dariusz-majchrzak/Meritum-2/Meritum2_KLT/img/Meritum2_KLT_BOT.png

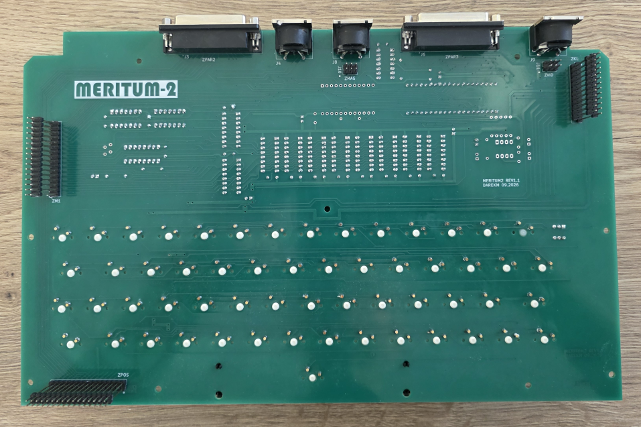
Meritum2_KLT/img/Meritum2_KLT_BOT.png
