dariusz-majchrzak/Meritum-2/Meritum2_KLT/img/Meritum2_KLT_PCB_TOP.png

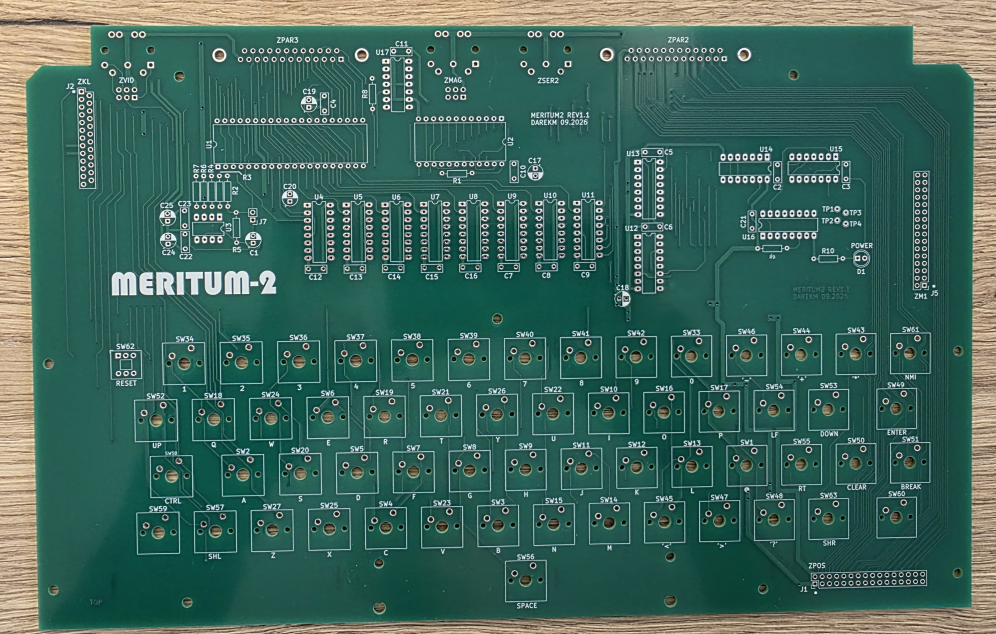
Meritum2_KLT/img/Meritum2_KLT_PCB_TOP.png
