dariusz-majchrzak/Meritum-2/Meritum2_KLT/img/Meritum2_KLT_TOP.png

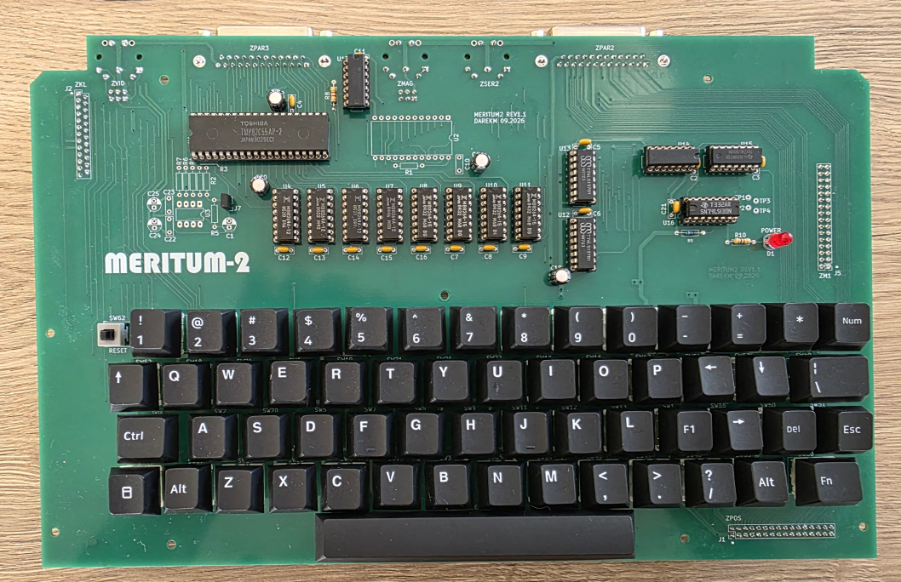
Meritum2_KLT/img/Meritum2_KLT_TOP.png
