dariusz-majchrzak/Meritum-2/Meritum2_PGW/img/Meritum2_PCBs_stack1.png

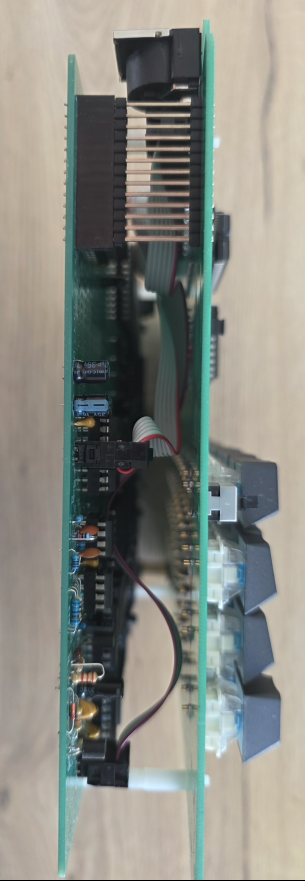
Meritum2_PGW/img/Meritum2_PCBs_stack1.png
