dariusz-majchrzak/Meritum-2/Meritum2_PGW/img/Meritum2_PGW_PCB_BOT.png

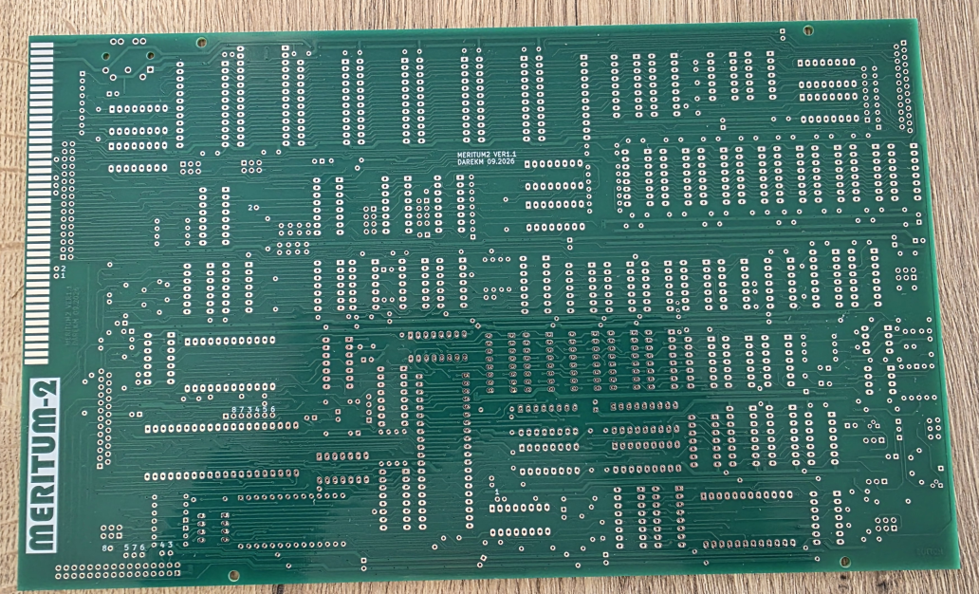
Meritum2_PGW/img/Meritum2_PGW_PCB_BOT.png
