dariusz-majchrzak/Meritum-2/Meritum2_KLT/schematic/Meritum2_KLT.pdf

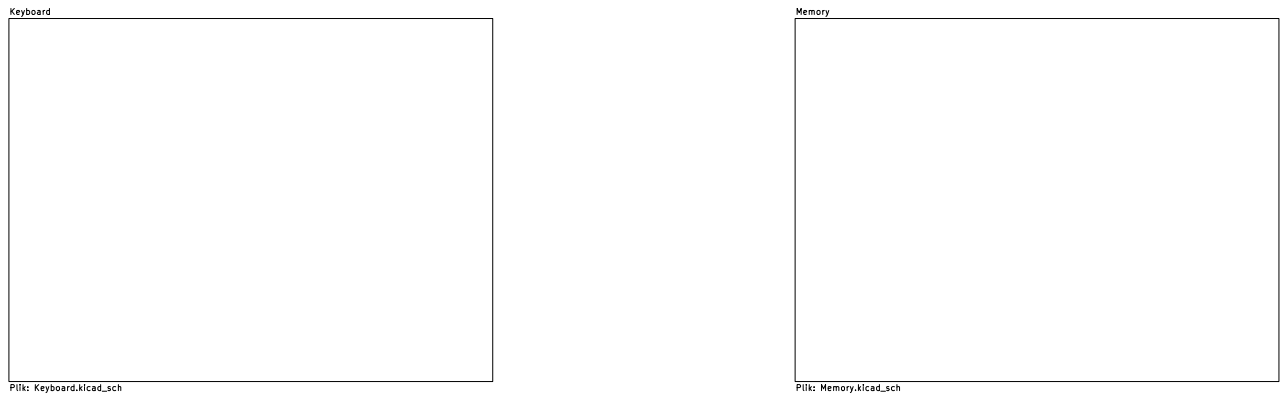
[picture p18: page 1]

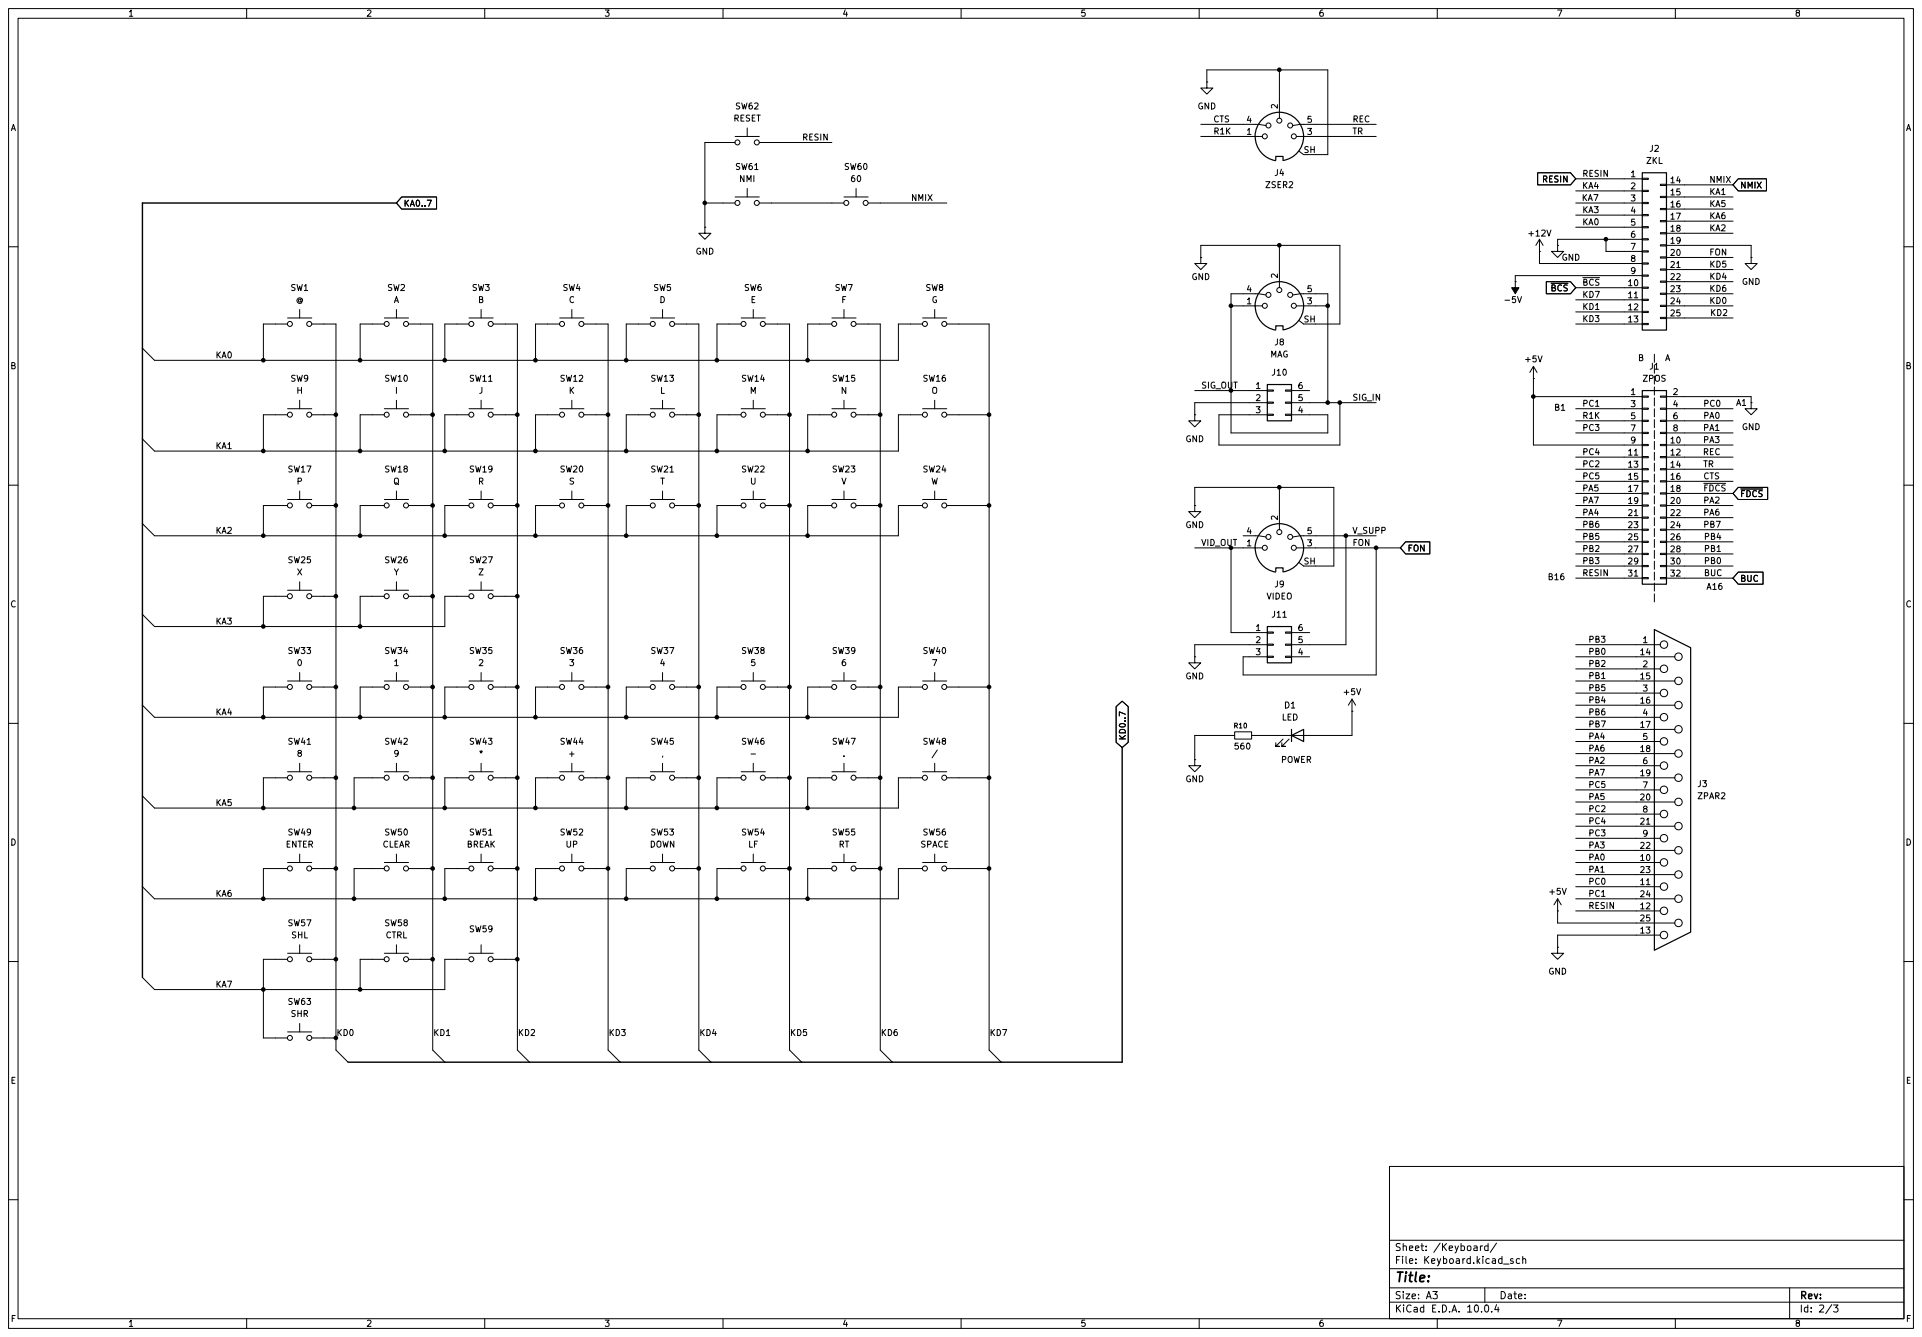
[picture p19: page 2]

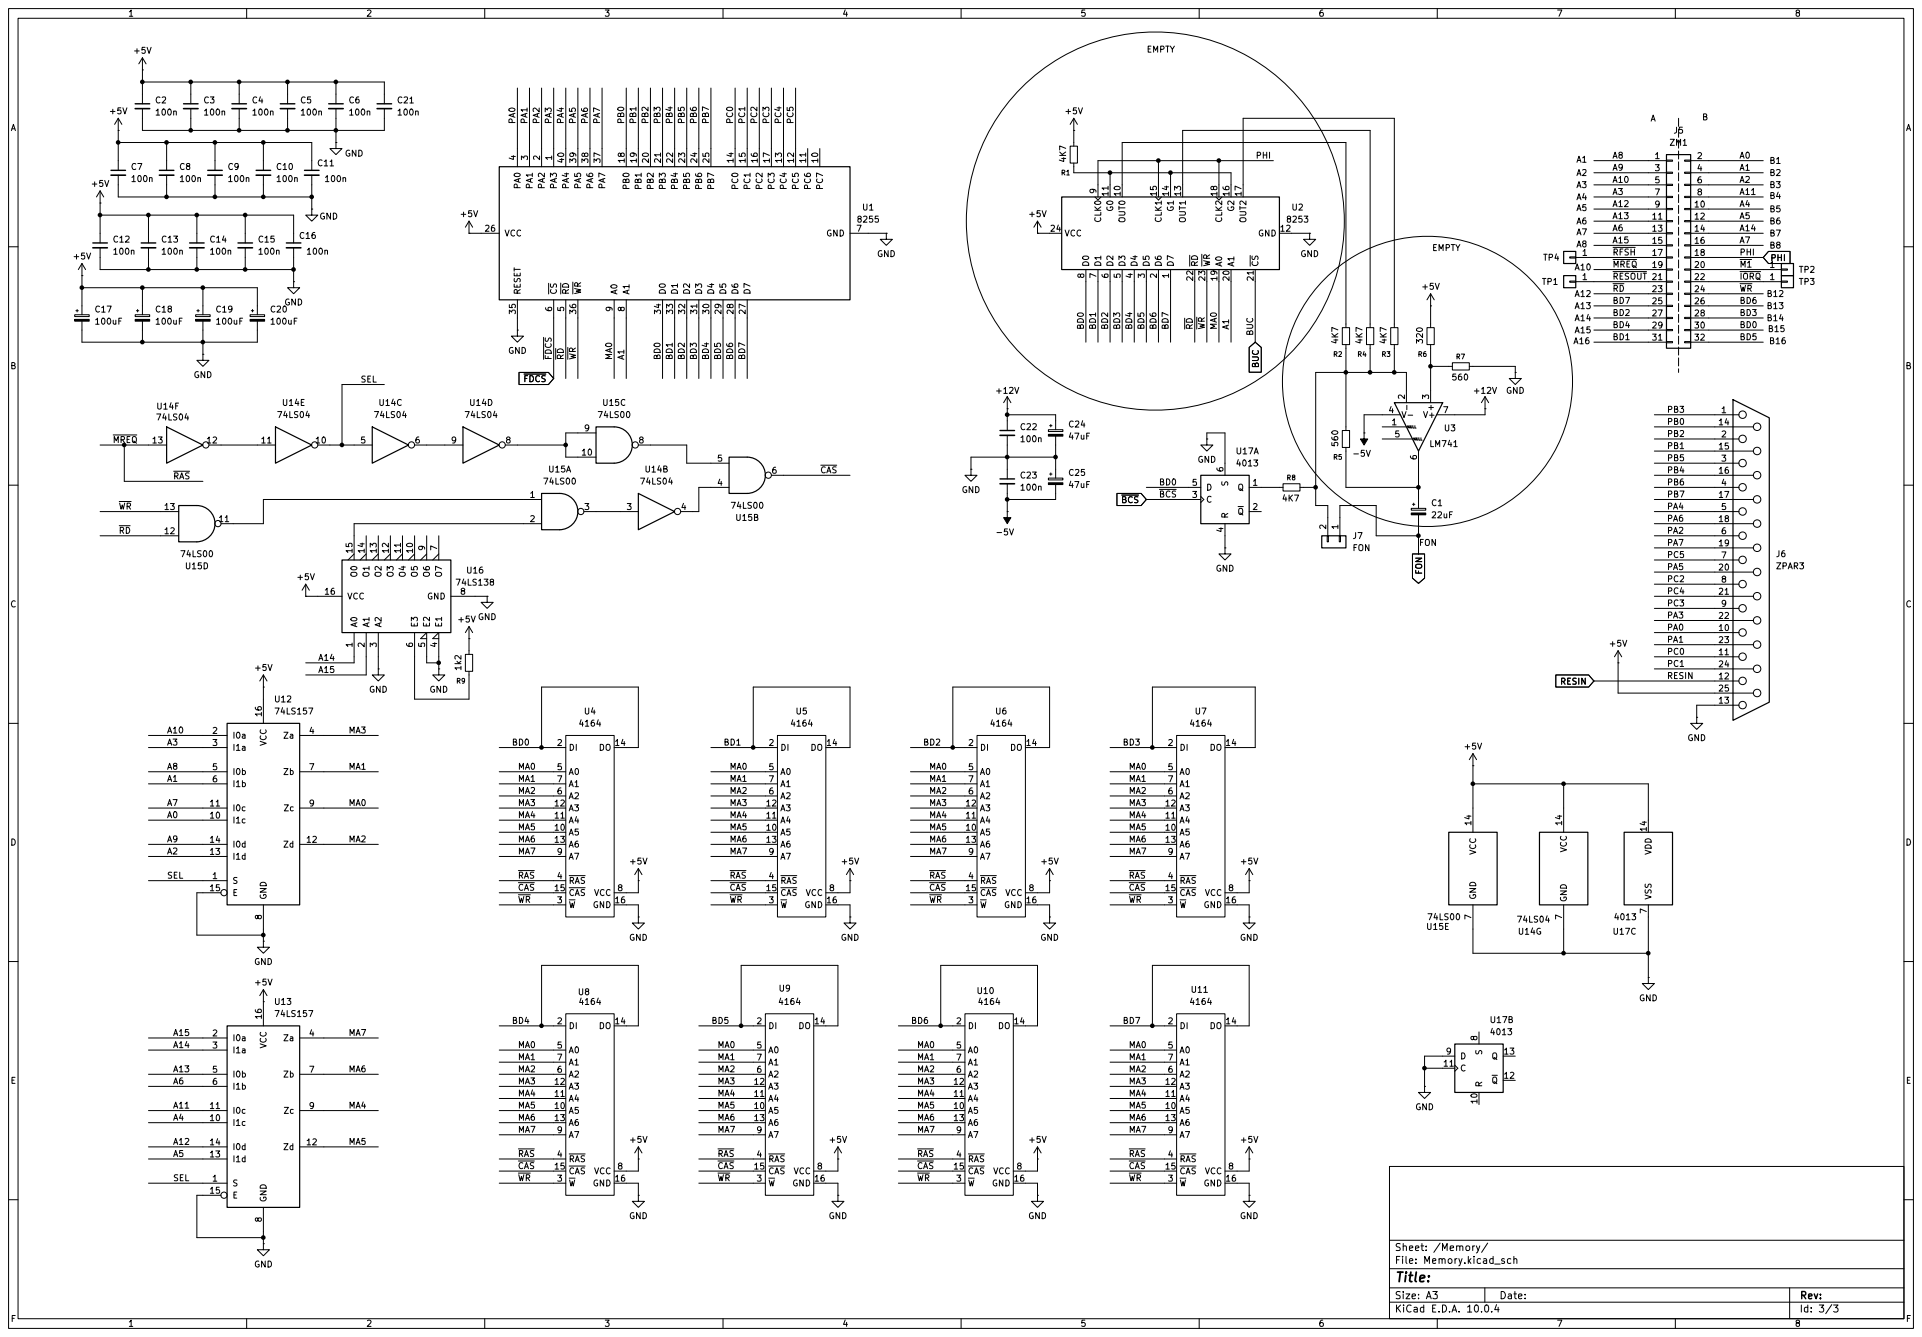
[picture p20: page 3]
