dariusz-majchrzak/Meritum-2/Meritum2_KLT/kicad/Meritum_KLT.kicad_pcb

## KiCad design Meritum2_KLT/kicad/Meritum_KLT.kicad_pcb (2026-11-09)

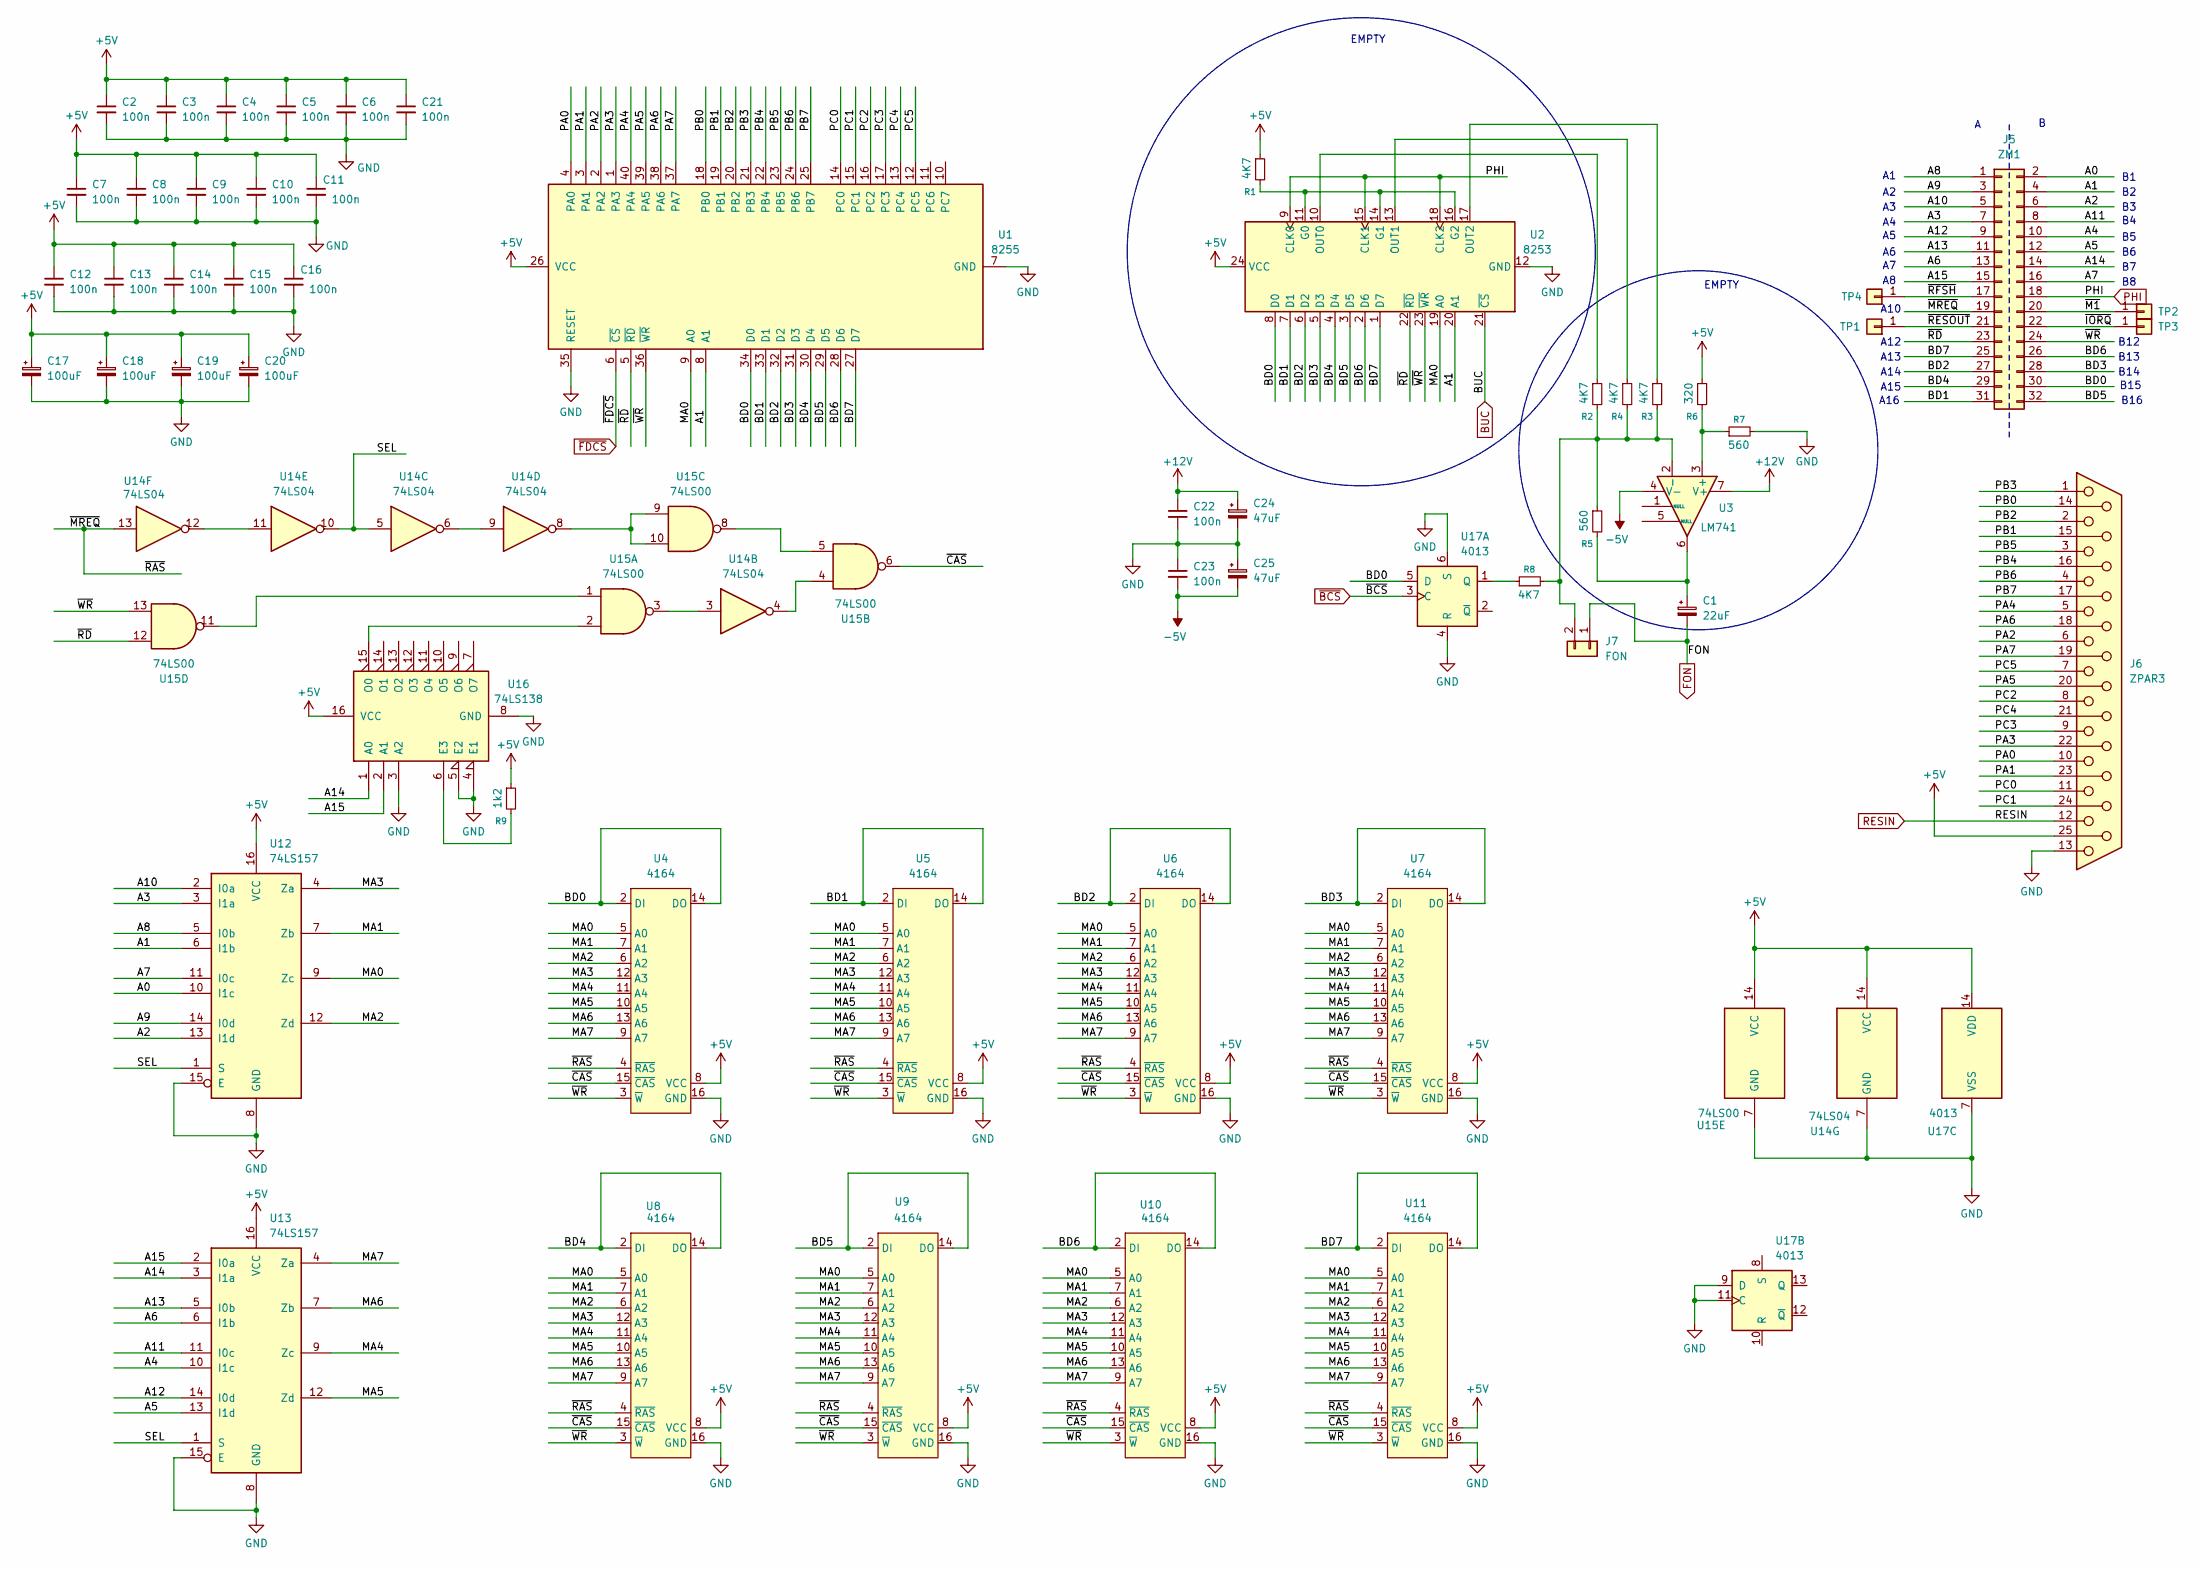
[picture p21: schematic Memory.kicad_sch]

Parts:
C1: 22uF; CP_Radial_D5.0mm_P2.50mm
C2, C3, C4, C5, C6, C7, C8, C9, C10, C11, C12, C13, C14, C15, C16, C21, C22, C23: 100n; C_Rect_L7.0mm_W2.5mm_P5.00mm
C17, C18, C19, C20: 100uF; CP_Radial_D5.0mm_P2.50mm
C24, C25: 47uF; CP_Radial_D5.0mm_P2.50mm
J5: ZM1; PinHeader_2x16_P2.54mm_Vertical
J6: ZPAR3; DSUB-25_Socket_Horizontal_P2.77x2.84mm_EdgePinOffset7.70mm_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
J7: FON; PinHeader_1x02_P2.54mm_Vertical
R1, R2, R3, R4, R8: 4K7; r_400
R5, R7: 560; r_400
R6: 320; r_400
R9: 1k2; r_400
TP1, TP2, TP3, TP4: TP; pin
U1: 8255; DIP-40_W15.24mm
U2: 8253; DIP-24_W15.24mm
U3: LM741; DIP-8_W7.62mm_LongPads
U4, U5, U6, U7, U8, U9, U10, U11: 4164; DIP-16_W7.62mm_LongPads
U12, U13: 74LS157; DIP-16_W7.62mm_LongPads
U14: 74LS04; DIP-14_W7.62mm_LongPads
U15: 74LS00; DIP-14_W7.62mm_LongPads
U16: 74LS138; DIP-16_W7.62mm_LongPads
U17: 4013; DIP-14_W7.62mm_LongPads

Connections:
+5V: C2.1, C3.1, C4.1, C5.1, C6.1, C7.1, C8.1, C9.1, C10.1, C11.1, C12.1, C13.1, C14.1, C15.1, C16.1, C17.1, C18.1, C19.1, C20.1, C21.1, J6.25, R1.1, R6.1, R9.1, U1.26 (VCC), U2.24 (VCC), U4.8 (VCC), U5.8 (VCC), U6.8 (VCC), U7.8 (VCC), U8.8 (VCC), U9.8 (VCC), U10.8 (VCC), U11.8 (VCC), U12.16 (VCC), U13.16 (VCC), U14.14 (VCC), U15.14 (VCC), U16.16 (VCC), U17.14 (VDD); also elsewhere on the board
+12V: C22.1, C24.1, U3.7 (V+); also elsewhere on the board
-5V: C23.2, C25.2, U3.4 (V-); also elsewhere on the board
/Memory/A0: J5.2, U12.10 (I1c)
/Memory/A1: J5.4, U1.8 (A1), U2.20 (A1), U12.6 (I1b)
/Memory/A2: J5.6, U12.13 (I1d)
/Memory/A3: J5.7, U12.3 (I1a)
/Memory/A4: J5.10, U13.10 (I1c)
/Memory/A5: J5.12, U13.13 (I1d)
/Memory/A6: J5.13, U13.6 (I1b)
/Memory/A7: J5.16, U12.11 (I0c)
/Memory/A8: J5.1, U12.5 (I0b)
/Memory/A9: J5.3, U12.14 (I0d)
/Memory/A10: J5.5, U12.2 (I0a)
/Memory/A11: J5.8, U13.11 (I0c)
/Memory/A12: J5.9, U13.14 (I0d)
/Memory/A13: J5.11, U13.5 (I0b)
/Memory/A14: J5.14, U13.3 (I1a), U16.1 (A0)
/Memory/A15: J5.15, U13.2 (I0a), U16.2 (A1)
/Memory/BD0: J5.30, U1.34 (D0), U2.8 (D0), U4.2 (DI), U4.14 (DO), U17.5 (D)
/Memory/BD1: J5.31, U1.33 (D1), U2.7 (D1), U5.2 (DI), U5.14 (DO)
/Memory/BD2: J5.27, U1.32 (D2), U2.6 (D2), U6.2 (DI), U6.14 (DO)
/Memory/BD3: J5.28, U1.31 (D3), U2.5 (D3), U7.2 (DI), U7.14 (DO)
/Memory/BD4: J5.29, U1.30 (D4), U2.4 (D4), U8.2 (DI), U8.14 (DO)
/Memory/BD5: J5.32, U1.29 (D5), U2.3 (D5), U9.2 (DI), U9.14 (DO)
/Memory/BD6: J5.26, U1.28 (D6), U2.2 (D6), U10.2 (DI), U10.14 (DO)
/Memory/BD7: J5.25, U1.27 (D7), U2.1 (D7), U11.2 (DI), U11.14 (DO)
/Memory/MA0: U1.9 (A0), U2.19 (A0), U4.5 (A0), U5.5 (A0), U6.5 (A0), U7.5 (A0), U8.5 (A0), U9.5 (A0), U10.5 (A0), U11.5 (A0), U12.9 (Zc)
/Memory/MA1: U4.7 (A1), U5.7 (A1), U6.7 (A1), U7.7 (A1), U8.7 (A1), U9.7 (A1), U10.7 (A1), U11.7 (A1), U12.7 (Zb)
/Memory/MA2: U4.6 (A2), U5.6 (A2), U6.6 (A2), U7.6 (A2), U8.6 (A2), U9.6 (A2), U10.6 (A2), U11.6 (A2), U12.12 (Zd)
/Memory/MA3: U4.12 (A3), U5.12 (A3), U6.12 (A3), U7.12 (A3), U8.12 (A3), U9.12 (A3), U10.12 (A3), U11.12 (A3), U12.4 (Za)
/Memory/MA4: U4.11 (A4), U5.11 (A4), U6.11 (A4), U7.11 (A4), U8.11 (A4), U9.11 (A4), U10.11 (A4), U11.11 (A4), U13.9 (Zc)
/Memory/MA5: U4.10 (A5), U5.10 (A5), U6.10 (A5), U7.10 (A5), U8.10 (A5), U9.10 (A5), U10.10 (A5), U11.10 (A5), U13.12 (Zd)
/Memory/MA6: U4.13 (A6), U5.13 (A6), U6.13 (A6), U7.13 (A6), U8.13 (A6), U9.13 (A6), U10.13 (A6), U11.13 (A6), U13.7 (Zb)
/Memory/MA7: U4.9 (A7), U5.9 (A7), U6.9 (A7), U7.9 (A7), U8.9 (A7), U9.9 (A7), U10.9 (A7), U11.9 (A7), U13.4 (Za)
/Memory/PA0: J6.10, U1.4 (PA0)
/Memory/PA1: J6.23, U1.3 (PA1)
/Memory/PA2: J6.6, U1.2 (PA2)
/Memory/PA3: J6.22, U1.1 (PA3)
/Memory/PA4: J6.5, U1.40 (PA4)
/Memory/PA5: J6.20, U1.39 (PA5)
/Memory/PA6: J6.18, U1.38 (PA6)
/Memory/PA7: J6.19, U1.37 (PA7)
/Memory/PB0: J6.14, U1.18 (PB0)
/Memory/PB1: J6.15, U1.19 (PB1)
/Memory/PB2: J6.2, U1.20 (PB2)
/Memory/PB3: J6.1, U1.21 (PB3)
/Memory/PB4: J6.16, U1.22 (PB4)
/Memory/PB5: J6.3, U1.23 (PB5)
/Memory/PB6: J6.4, U1.24 (PB6)
/Memory/PB7: J6.17, U1.25 (PB7)
/Memory/PC0: J6.11, U1.14 (PC0)
/Memory/PC1: J6.24, U1.15 (PC1)
/Memory/PC2: J6.8, U1.16 (PC2)
/Memory/PC3: J6.9, U1.17 (PC3)
/Memory/PC4: J6.21, U1.13 (PC4)
/Memory/PC5: J6.7, U1.12 (PC5)
/Memory/SEL: U12.1 (S), U13.1 (S), U14.5, U14.10
/Memory/~CAS: U4.15 (~CAS), U5.15 (~CAS), U6.15 (~CAS), U7.15 (~CAS), U8.15 (~CAS), U9.15 (~CAS), U10.15 (~CAS), U11.15 (~CAS), U15.6
/Memory/~IORQ: J5.22, TP3.1 (Pin_1_1)
/Memory/~M1: J5.20, TP2.1 (Pin_1_1)
/Memory/~MREQ: J5.19, U4.4 (~RAS), U5.4 (~RAS), U6.4 (~RAS), U7.4 (~RAS), U8.4 (~RAS), U9.4 (~RAS), U10.4 (~RAS), U11.4 (~RAS), U14.13
/Memory/~RD: J5.23, U1.5 (~RD), U2.22 (~RD), U15.12
/Memory/~RESOUT: J5.21, TP1.1 (Pin_1_1)
/Memory/~RFSH: J5.17, TP4.1 (Pin_1_1)
/Memory/~WR: J5.24, U1.36 (~WR), U2.23 (~WR), U4.3 (~W), U5.3 (~W), U6.3 (~W), U7.3 (~W), U8.3 (~W), U9.3 (~W), U10.3 (~W), U11.3 (~W), U15.13
BUC: U2.21 (~CS); also elsewhere on the board
FON: C1.2, J7.1; also elsewhere on the board
GND: C2.2, C3.2, C4.2, C5.2, C6.2, C7.2, C8.2, C9.2, C10.2, C11.2, C12.2, C13.2, C14.2, C15.2, C16.2, C17.2, C18.2, C19.2, C20.2, C21.2, C22.2, C23.1, C24.2, C25.1, J6.13, R7.2, U1.7 (GND), U1.35 (RESET), U2.12 (GND), U4.16 (GND), U5.16 (GND), U6.16 (GND), U7.16 (GND), U8.16 (GND), U9.16 (GND), U10.16 (GND), U11.16 (GND), U12.8 (GND), U12.15 (E), U13.8 (GND), U13.15 (E), U14.7 (GND), U15.7 (GND), U16.3 (A2), U16.4 (E1), U16.5 (E2), U16.8 (GND), U17.4 (R), U17.6 (S), U17.7 (VSS), U17.9 (D), U17.11 (C); also elsewhere on the board
unnamed: C1.1, R5.2, U3.6
unnamed: J7.2, R2.2, R3.2, R4.2, R5.1, R8.2, U3.2 (-)
unnamed: R1.2, U2.11 (G0), U2.14 (G1), U2.16 (G2)
unnamed: R2.1, U2.10 (OUT0)
unnamed: R4.1, U2.13 (OUT1)
unnamed: R3.1, U2.17 (OUT2)
unnamed: R6.2, R7.1, U3.3 (+)
unnamed: U14.3, U15.3
unnamed: U14.4, U15.4
unnamed: U14.6, U14.9
unnamed: U14.8, U15.9, U15.10
unnamed: U14.11, U14.12
unnamed: U15.1, U15.11
unnamed: U15.5, U15.8
unnamed: R9.2, U16.6 (E3)
unnamed: U15.2, U16.15 (O0)
unnamed: R8.1, U17.1 (Q)
PHI: J5.18, U2.9 (CLK0), U2.15 (CLK1), U2.18 (CLK2)
RESIN: J6.12; also elsewhere on the board
~BCS: U17.3 (C); also elsewhere on the board
~FDCS: U1.6 (~CS); also elsewhere on the board

Notes on the sheet:
B13
B12
EMPTY
A16
B15
A15
B16
A14
A13
A10
A12
B14

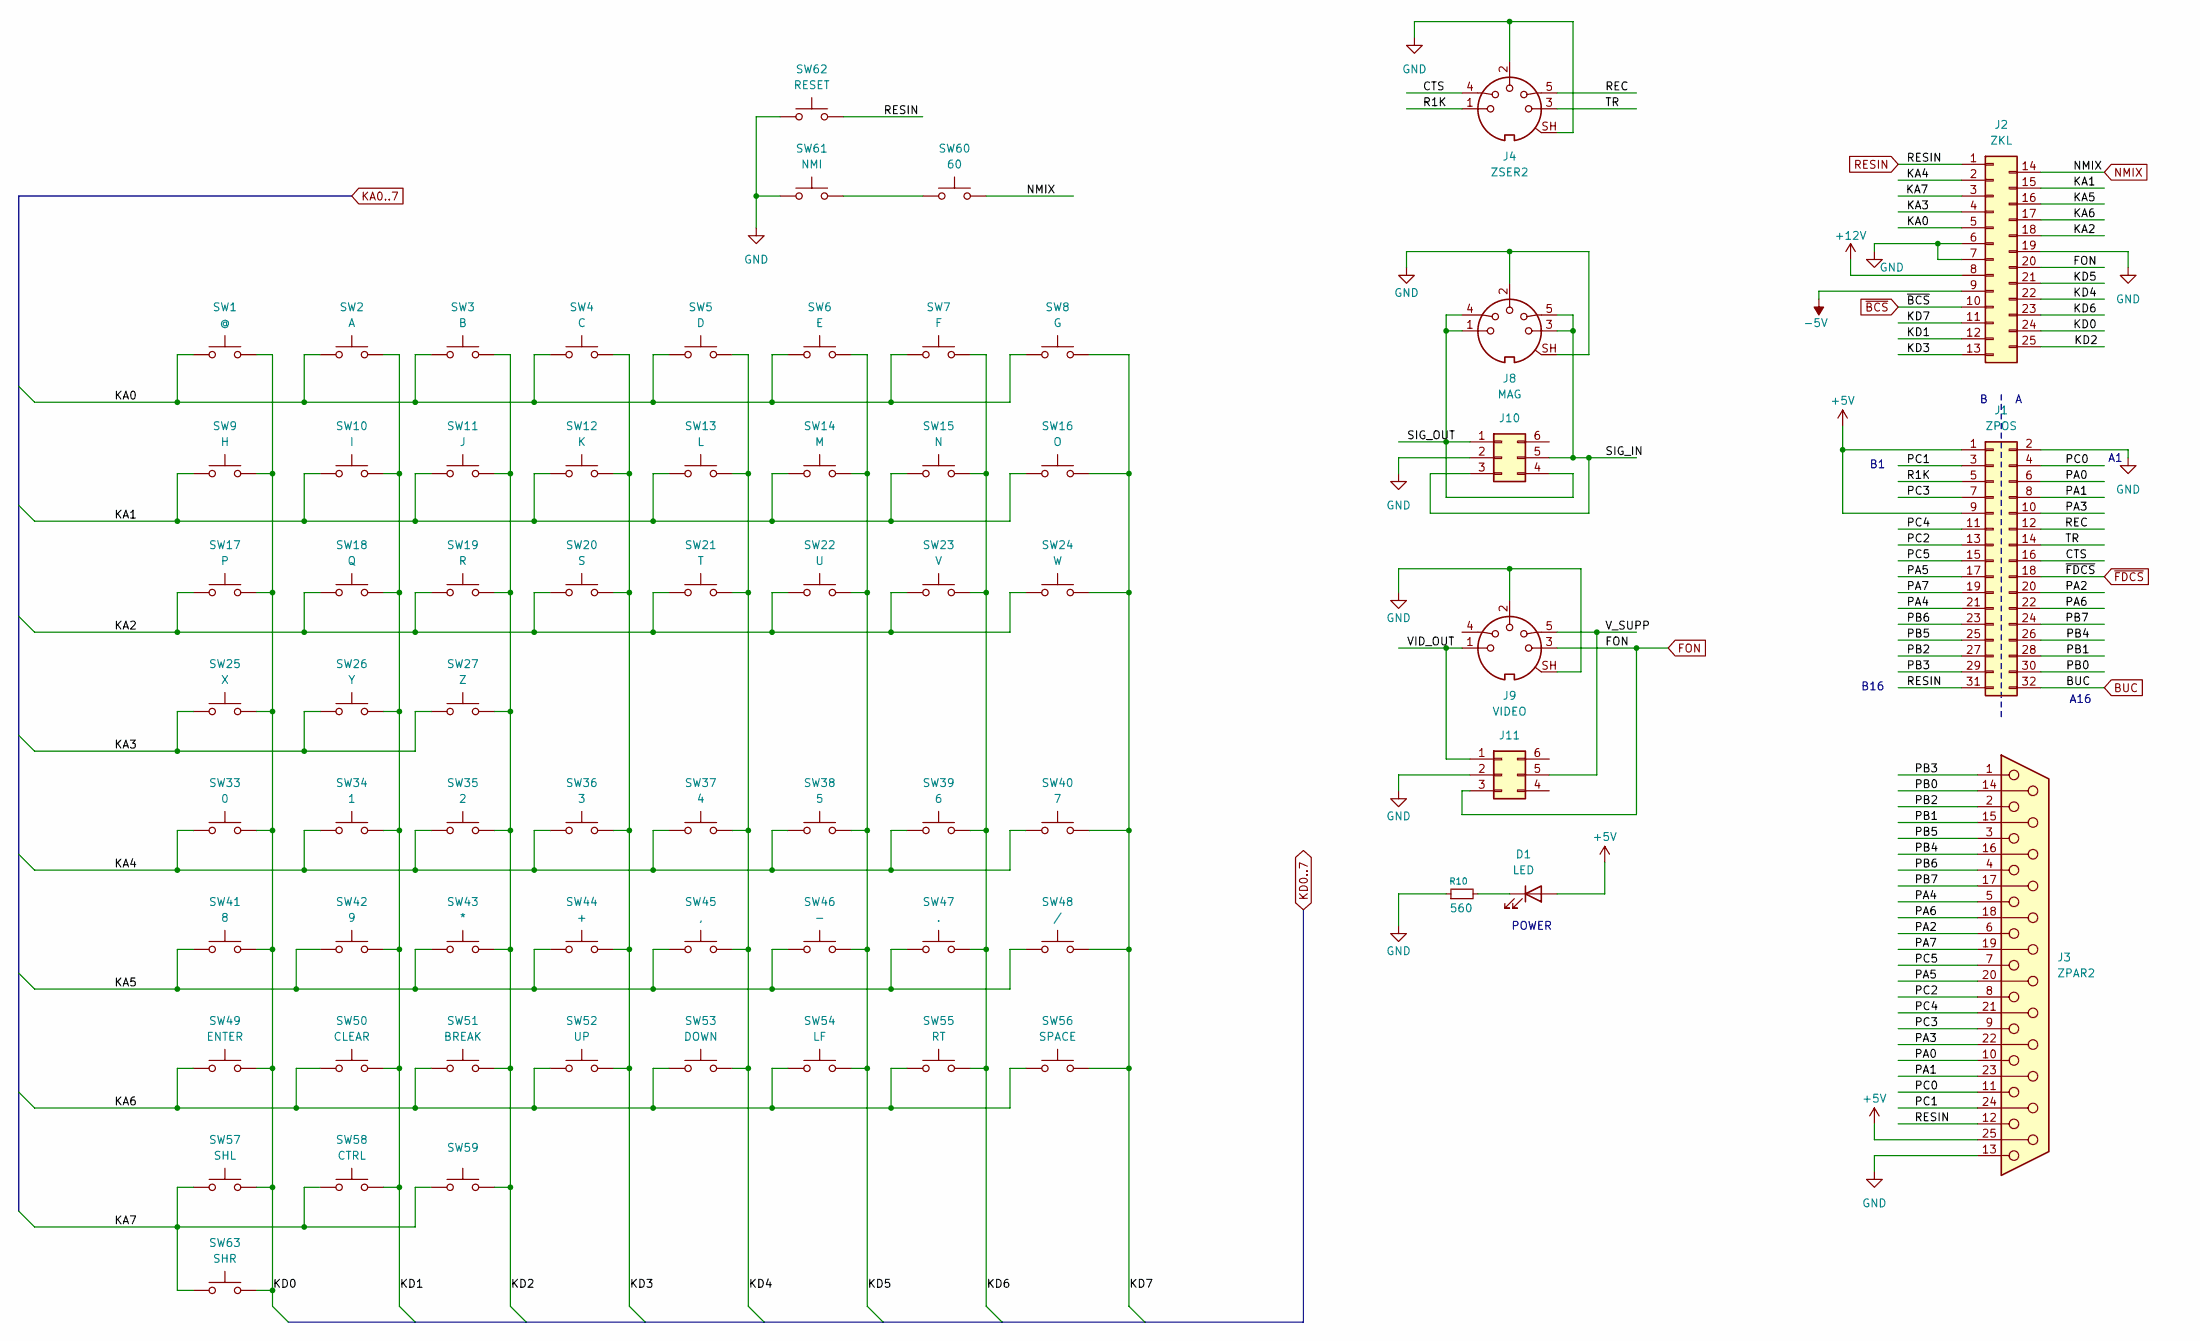
[picture p22: schematic Keyboard.kicad_sch]

Parts:
D1: LED; LED_D5.0mm
J1: ZPOS; PinHeader_2x16_P2.54mm_Vertical
J2: ZKL; PinSocket_25_P2.54mm_Vertical
J3: ZPAR2; DSUB-25_Socket_Horizontal_P2.77x2.84mm_EdgePinOffset7.70mm_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
J4: ZSER2; CUI_SDS-50J
J8: MAG; CUI_SDS-50J
J9: VIDEO; CUI_SDS-50J
J10, J11: Conn_02x03_Counter_Clockwise; PinHeader_2x03_P2.54mm_Vertical
R10: 560; r_400
SW1: @; SW_Cherry_MX_1.00u_PCB
SW2: A; SW_Cherry_MX_1.00u_PCB
SW3: B; SW_Cherry_MX_1.00u_PCB
SW4: C; SW_Cherry_MX_1.00u_PCB
SW5: D; SW_Cherry_MX_1.00u_PCB
SW6: E; SW_Cherry_MX_1.00u_PCB
SW7: F; SW_Cherry_MX_1.00u_PCB
SW8: G; SW_Cherry_MX_1.00u_PCB
SW9: H; SW_Cherry_MX_1.00u_PCB
SW10: I; SW_Cherry_MX_1.00u_PCB
SW11: J; SW_Cherry_MX_1.00u_PCB
SW12: K; SW_Cherry_MX_1.00u_PCB
SW13: L; SW_Cherry_MX_1.00u_PCB
SW14: M; SW_Cherry_MX_1.00u_PCB
SW15: N; SW_Cherry_MX_1.00u_PCB
SW16: O; SW_Cherry_MX_1.00u_PCB
SW17: P; SW_Cherry_MX_1.00u_PCB
SW18: Q; SW_Cherry_MX_1.00u_PCB
SW19: R; SW_Cherry_MX_1.00u_PCB
SW20: S; SW_Cherry_MX_1.00u_PCB
SW21: T; SW_Cherry_MX_1.00u_PCB
SW22: U; SW_Cherry_MX_1.00u_PCB
SW23: V; SW_Cherry_MX_1.00u_PCB
SW24: W; SW_Cherry_MX_1.00u_PCB
SW25: X; SW_Cherry_MX_1.00u_PCB
SW26: Y; SW_Cherry_MX_1.00u_PCB
SW27: Z; SW_Cherry_MX_1.00u_PCB
SW33: 0; SW_Cherry_MX_1.00u_PCB
SW34: 1; SW_Cherry_MX_1.00u_PCB
SW35: 2; SW_Cherry_MX_1.00u_PCB
SW36: 3; SW_Cherry_MX_1.00u_PCB
SW37: 4; SW_Cherry_MX_1.00u_PCB
SW38: 5; SW_Cherry_MX_1.00u_PCB
SW39: 6; SW_Cherry_MX_1.00u_PCB
SW40: 7; SW_Cherry_MX_1.00u_PCB
SW41: 8; SW_Cherry_MX_1.00u_PCB
SW42: 9; SW_Cherry_MX_1.00u_PCB
SW43: *; SW_Cherry_MX_1.00u_PCB
SW44: +; SW_Cherry_MX_1.00u_PCB
SW45: ,; SW_Cherry_MX_1.00u_PCB
SW46: -; SW_Cherry_MX_1.00u_PCB
SW47: .; SW_Cherry_MX_1.00u_PCB
SW48: /; SW_Cherry_MX_1.00u_PCB
SW49: ENTER; SW_Cherry_MX_1.50u_PCB
SW50: CLEAR; SW_Cherry_MX_1.00u_PCB
SW51: BREAK; SW_Cherry_MX_1.00u_PCB
SW52: UP; SW_Cherry_MX_1.00u_PCB
SW53: DOWN; SW_Cherry_MX_1.00u_PCB
SW54: LF; SW_Cherry_MX_1.00u_PCB
SW55: RT; SW_Cherry_MX_1.00u_PCB
SW56: SPACE; SW_Cherry_MX_6.25u_PCB
SW57: SHL; SW_Cherry_MX_1.00u_PCB
SW58: CTRL; SW_Cherry_MX_1.50u_PCB
SW59: SW_Cherry_MX_1.00u_PCB
SW60: 60; SW_Cherry_MX_1.50u_PCB
SW61: NMI; SW_Cherry_MX_1.00u_PCB
SW62: RESET; SW_Push_2P2T_Toggle_CK_PVA2OAH5xxxxxxV2
SW63: SHR; SW_Cherry_MX_1.00u_PCB

Connections:
+5V: D1.2 (A), J1.1, J1.9, J3.25; also elsewhere on the board
+12V: J2.8; also elsewhere on the board
-5V: J2.9; also elsewhere on the board
/Keyboard/CTS: J1.16, J4.4
/Keyboard/KA0: J2.5, SW1.1, SW2.1, SW3.1, SW4.1, SW5.1, SW6.1, SW7.1, SW8.1
/Keyboard/KA1: J2.15, SW9.1, SW10.1, SW11.1, SW12.1, SW13.1, SW14.1, SW15.1, SW16.1
/Keyboard/KA2: J2.18, SW17.1, SW18.1, SW19.1, SW20.1, SW21.1, SW22.1, SW23.1, SW24.1
/Keyboard/KA3: J2.4, SW25.1, SW26.1, SW27.1
/Keyboard/KA4: J2.2, SW33.1, SW34.1, SW35.1, SW36.1, SW37.1, SW38.1, SW39.1, SW40.1
/Keyboard/KA5: J2.16, SW41.1, SW42.1, SW43.1, SW44.1, SW45.1, SW46.1, SW47.1, SW48.1
/Keyboard/KA6: J2.17, SW49.1, SW50.1, SW51.1, SW52.1, SW53.1, SW54.1, SW55.1, SW56.1
/Keyboard/KA7: J2.3, SW57.1, SW58.1, SW59.1, SW63.1
/Keyboard/KD0: J2.24, SW1.2, SW9.2, SW17.2, SW25.2, SW33.2, SW41.2, SW49.2, SW57.2, SW63.2
/Keyboard/KD1: J2.12, SW2.2, SW10.2, SW18.2, SW26.2, SW34.2, SW42.2, SW50.2, SW58.2
/Keyboard/KD2: J2.25, SW3.2, SW11.2, SW19.2, SW27.2, SW35.2, SW43.2, SW51.2, SW59.2
/Keyboard/KD3: J2.13, SW4.2, SW12.2, SW20.2, SW36.2, SW44.2, SW52.2
/Keyboard/KD4: J2.22, SW5.2, SW13.2, SW21.2, SW37.2, SW45.2, SW53.2
/Keyboard/KD5: J2.21, SW6.2, SW14.2, SW22.2, SW38.2, SW46.2, SW54.2
/Keyboard/KD6: J2.23, SW7.2, SW15.2, SW23.2, SW39.2, SW47.2, SW55.2
/Keyboard/KD7: J2.11, SW8.2, SW16.2, SW24.2, SW40.2, SW48.2, SW56.2
/Keyboard/PA0: J1.6, J3.10
/Keyboard/PA1: J1.8, J3.23
/Keyboard/PA2: J1.20, J3.6
/Keyboard/PA3: J1.10, J3.22
/Keyboard/PA4: J1.21, J3.5
/Keyboard/PA5: J1.17, J3.20
/Keyboard/PA6: J1.22, J3.18
/Keyboard/PA7: J1.19, J3.19
/Keyboard/PB0: J1.30, J3.14
/Keyboard/PB1: J1.28, J3.15
/Keyboard/PB2: J1.27, J3.2
/Keyboard/PB3: J1.29, J3.1
/Keyboard/PB4: J1.26, J3.16
/Keyboard/PB5: J1.25, J3.3
/Keyboard/PB6: J1.23, J3.4
/Keyboard/PB7: J1.24, J3.17
/Keyboard/PC0: J1.4, J3.11
/Keyboard/PC1: J1.3, J3.24
/Keyboard/PC2: J1.13, J3.8
/Keyboard/PC3: J1.7, J3.9
/Keyboard/PC4: J1.11, J3.21
/Keyboard/PC5: J1.15, J3.7
/Keyboard/R1K: J1.5, J4.1
/Keyboard/REC: J1.12, J4.5
/Keyboard/SIG_IN: J8.3, J8.5, J10.3, J10.5
/Keyboard/SIG_OUT: J8.1, J8.4, J10.1, J10.4
/Keyboard/TR: J1.14, J4.3
/Keyboard/VID_OUT: J9.1, J11.1
/Keyboard/V_SUPP: J9.5, J11.5
BUC: J1.32; also elsewhere on the board
FON: J2.20, J9.3, J11.3; also elsewhere on the board
GND: J1.2, J2.6, J2.7, J2.19, J3.13, J4.2, J4.SH, J8.2, J8.SH, J9.2, J9.SH, J10.2, J11.2, R10.1, SW61.1, SW62.1; also elsewhere on the board
NMIX: J2.14, SW60.2
unnamed: D1.1 (K), R10.2
unnamed: SW60.1, SW61.2
RESIN: J1.31, J2.1, J3.12, SW62.2; also elsewhere on the board
~BCS: J2.10; also elsewhere on the board
~FDCS: J1.18; also elsewhere on the board

Notes on the sheet:
POWER
B16
A16

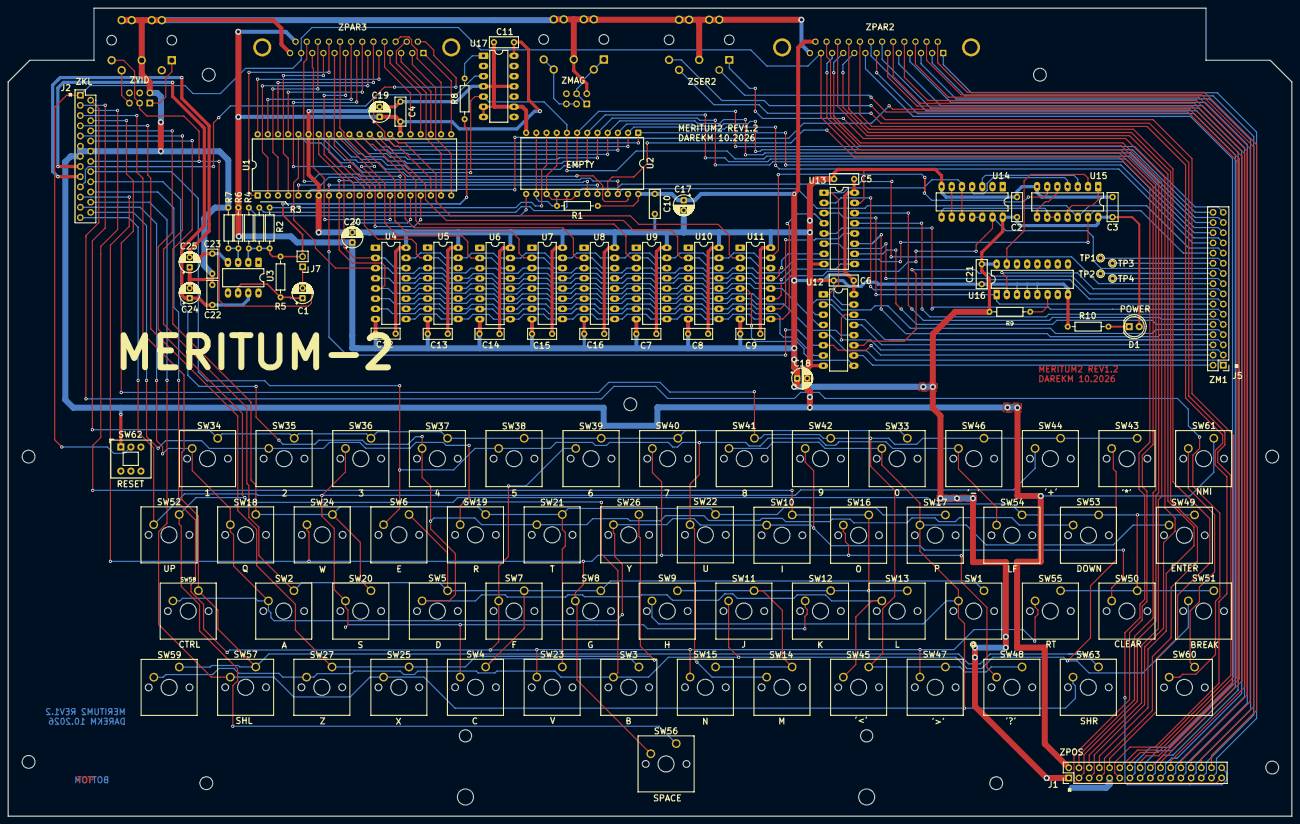
[picture p23: board Meritum_KLT.kicad_pcb from above]

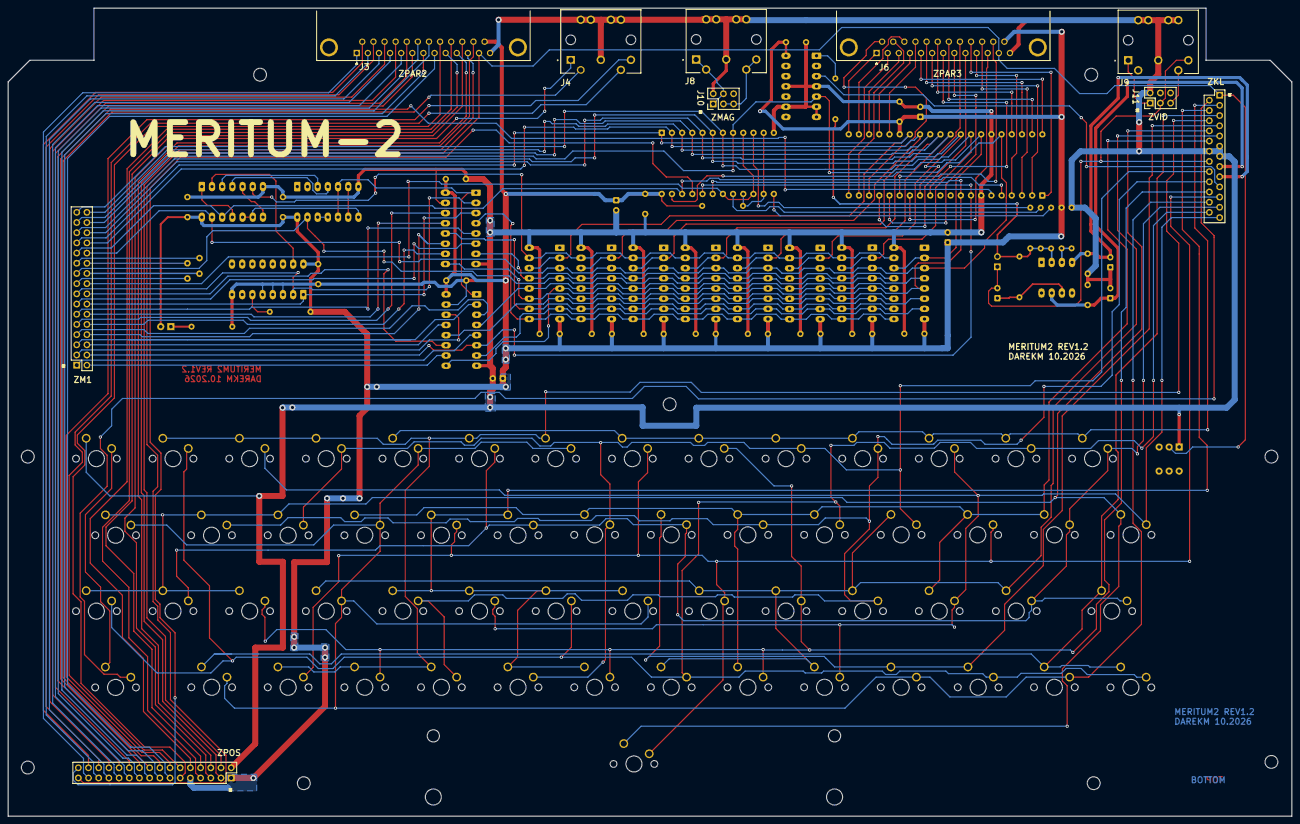
[picture p24: board Meritum_KLT.kicad_pcb from below]

Board: 2 copper layers, 320.0 x 201.4 mm, 126 parts (7 on the bottom side), 139 nets.
