dariusz-majchrzak/Meritum-2/Meritum2_PGW/kicad/Meritum_PGW.kicad_pcb

## KiCad design Meritum2_PGW/kicad/Meritum_PGW.kicad_pcb (2026-11-09)

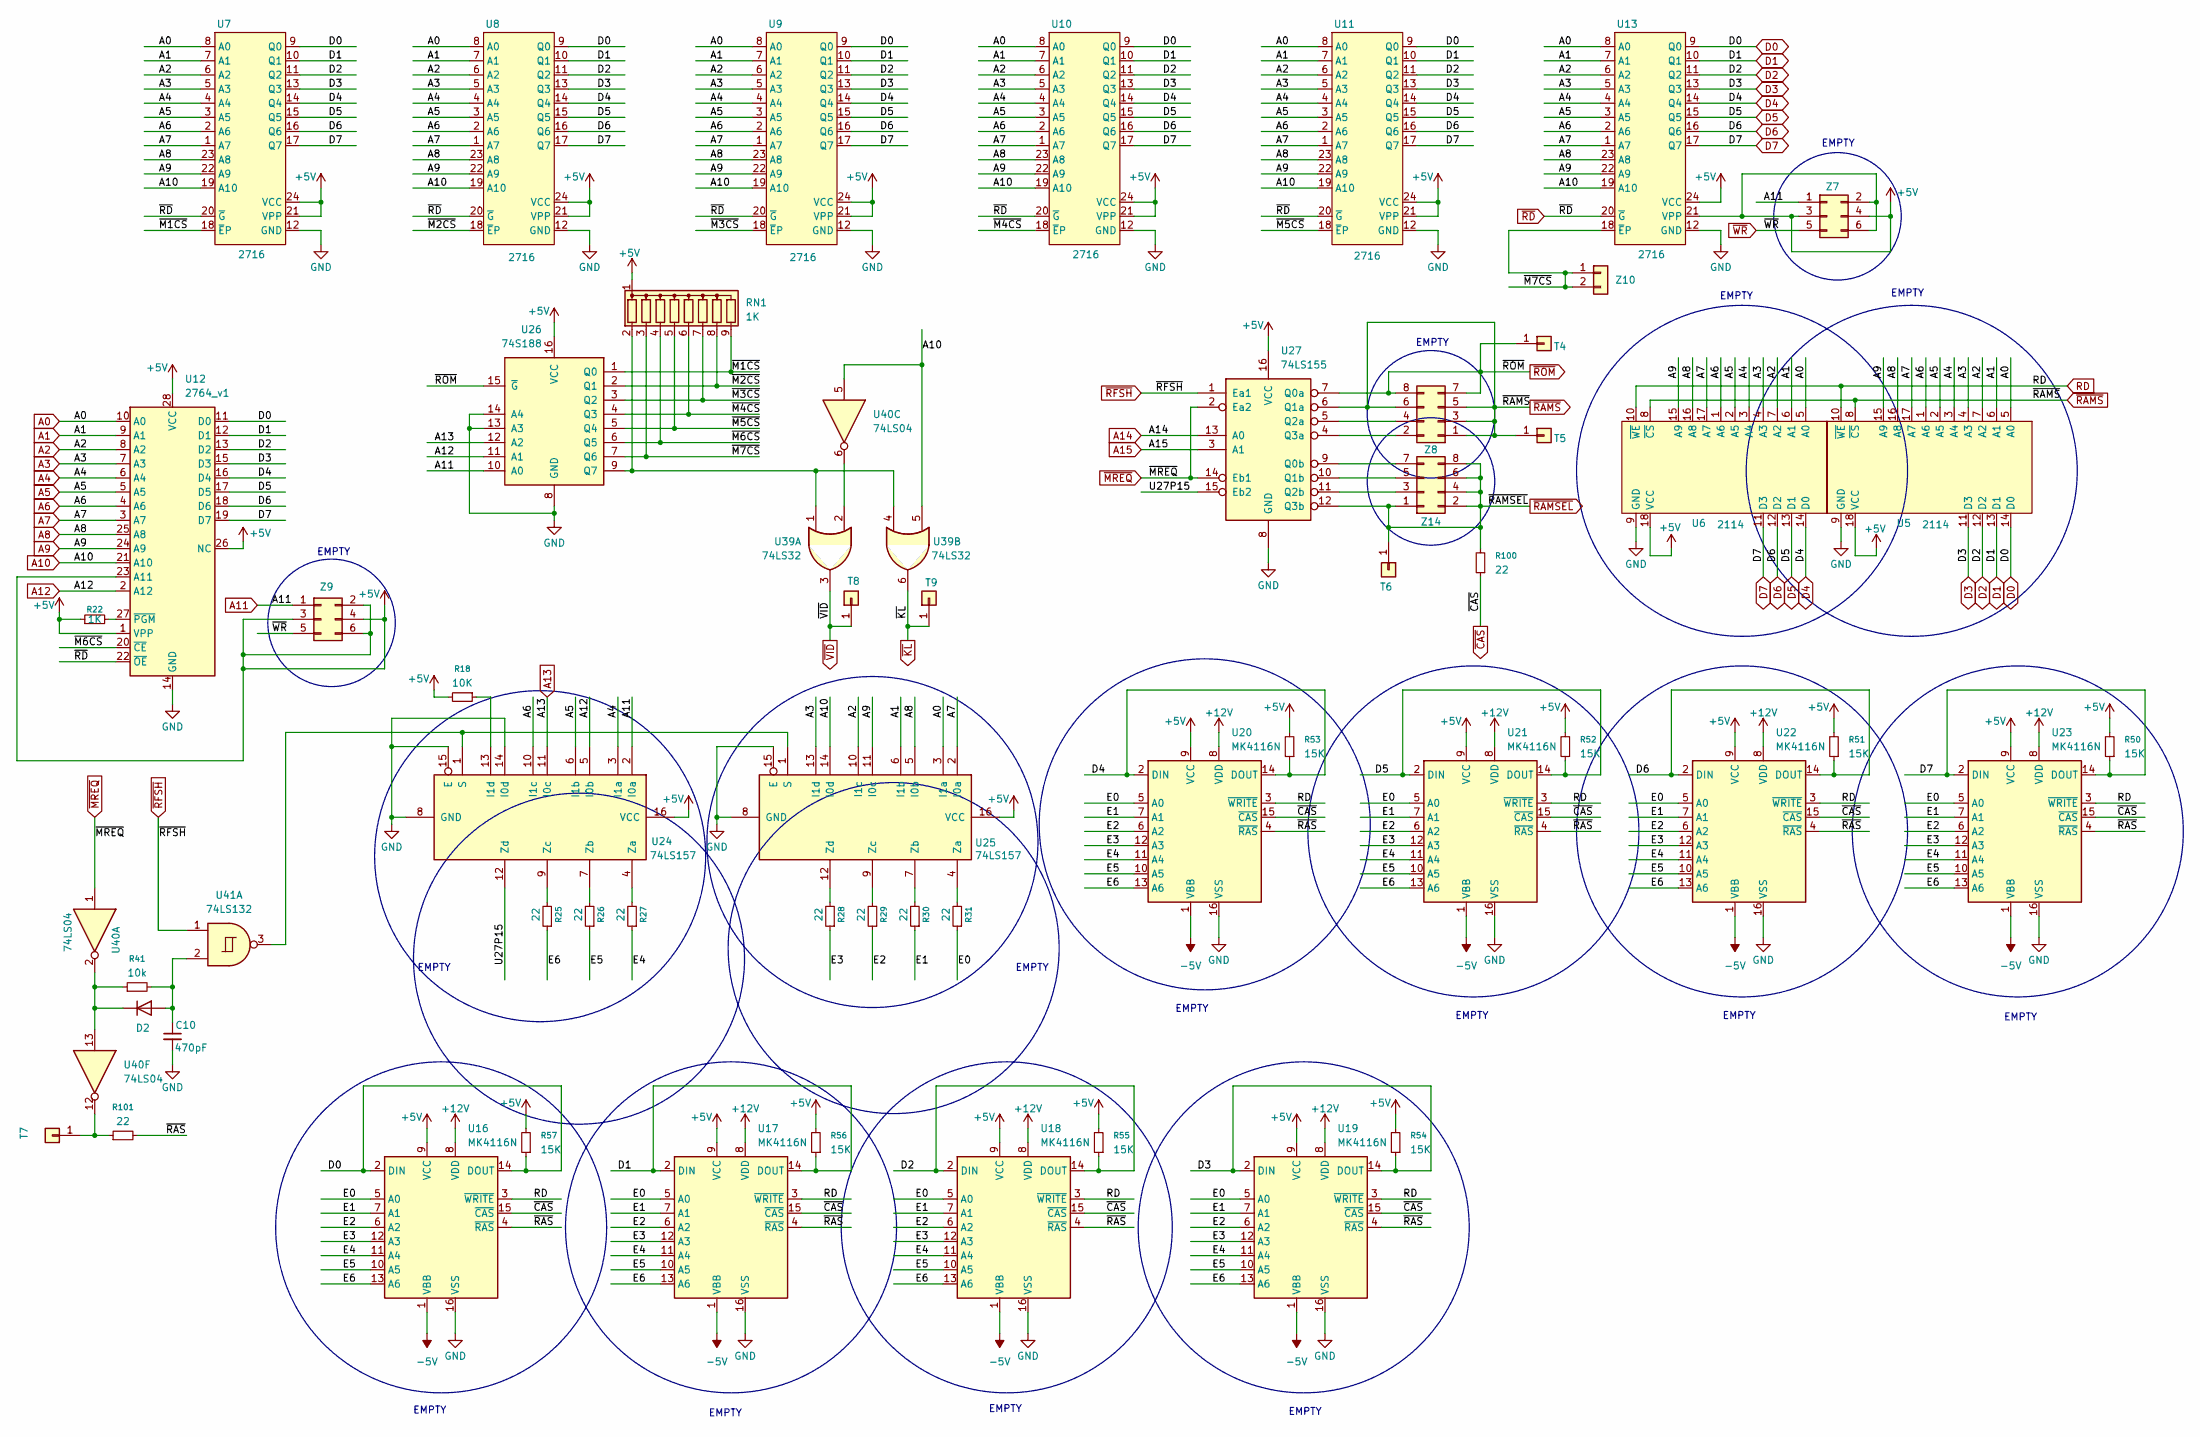
[picture p25: schematic MEM.kicad_sch, KOMPUTER MERITUM-1]

Parts:
C10: 470pF; c_100
D2: 1N4148; D_DO-35_SOD27_P10.16mm_Horizontal
R18: 10K; r_400
R22: 1K; R_Axial_DIN0207_L6.3mm_D2.5mm_P2.54mm_Vertical
R25, R26, R27, R28, R29, R30, R31, R100, R101: 22; r_400
R41: 10k; r_400
R50, R51, R52, R53, R54, R55, R56, R57: 15K; R_Axial_DIN0207_L6.3mm_D2.5mm_P2.54mm_Vertical
RN1: 1K; R_Array_SIP9
T4, T5, T6, T7, T8, T9: T18; pin
U5, U6: 2114; DIP-18_W7.62mm_Socket_LongPads
U7, U8, U9, U10, U11, U13: 2716; DIP-24_W15.24mm_LongPads
U12: 2764_v1; DIP-28_W15.24mm_LongPads
U16, U17, U18, U19, U20, U21, U22, U23: MK4116N; DIP-16_W7.62mm_LongPads
U24, U25: 74LS157; DIP-16_W7.62mm_LongPads
U26: 74S188; DIP-16_W7.62mm_LongPads
U27: 74LS155; DIP-16_W7.62mm_LongPads
U39: 74LS32; DIP-14_W7.62mm_LongPads
U40: 74LS04; DIP-14_W7.62mm_LongPads
U41: 74LS132; DIP-14_W7.62mm_LongPads
Z7: Z3; PinHeader_2x03_P2.54mm_Vertical
Z8, Z14: Conn_02x04_Odd_Even; PinHeader_2x04_P2.54mm_Vertical
Z9: Z4; PinHeader_2x03_P2.54mm_Vertical
Z10: Conn_01x02; PinHeader_1x02_P2.54mm_Vertical

Connections:
+5V: R18.2, R22.1, R50.2, R51.2, R52.2, R53.2, R54.2, R55.2, R56.2, R57.2, RN1.1 (common), U5.18 (VCC), U6.18 (VCC), U7.21 (VPP), U7.24 (VCC), U8.21 (VPP), U8.24 (VCC), U9.21 (VPP), U9.24 (VCC), U10.21 (VPP), U10.24 (VCC), U11.21 (VPP), U11.24 (VCC), U12.1 (VPP), U12.23 (A11), U12.26 (NC), U12.28 (VCC), U13.21 (VPP), U13.24 (VCC), U16.9 (VCC), U17.9 (VCC), U18.9 (VCC), U19.9 (VCC), U20.9 (VCC), U21.9 (VCC), U22.9 (VCC), U23.9 (VCC), U24.16 (VCC), U25.16 (VCC), U26.16 (VCC), U27.16 (VCC), Z7.2, Z7.3, Z7.4, Z7.6, Z9.2, Z9.3, Z9.4, Z9.6; also elsewhere on the board
+12V: U16.8 (VDD), U17.8 (VDD), U18.8 (VDD), U19.8 (VDD), U20.8 (VDD), U21.8 (VDD), U22.8 (VDD), U23.8 (VDD); also elsewhere on the board
-5V: U16.1 (VBB), U17.1 (VBB), U18.1 (VBB), U19.1 (VBB), U20.1 (VBB), U21.1 (VBB), U22.1 (VBB), U23.1 (VBB); also elsewhere on the board
/MEM/E0: R31.1, U16.5 (A0), U17.5 (A0), U18.5 (A0), U19.5 (A0), U20.5 (A0), U21.5 (A0), U22.5 (A0), U23.5 (A0)
/MEM/E1: R30.1, U16.7 (A1), U17.7 (A1), U18.7 (A1), U19.7 (A1), U20.7 (A1), U21.7 (A1), U22.7 (A1), U23.7 (A1)
/MEM/E2: R29.1, U16.6 (A2), U17.6 (A2), U18.6 (A2), U19.6 (A2), U20.6 (A2), U21.6 (A2), U22.6 (A2), U23.6 (A2)
/MEM/E3: R28.1, U16.12 (A3), U17.12 (A3), U18.12 (A3), U19.12 (A3), U20.12 (A3), U21.12 (A3), U22.12 (A3), U23.12 (A3)
/MEM/E4: R27.1, U16.11 (A4), U17.11 (A4), U18.11 (A4), U19.11 (A4), U20.11 (A4), U21.11 (A4), U22.11 (A4), U23.11 (A4)
/MEM/E5: R26.1, U16.10 (A5), U17.10 (A5), U18.10 (A5), U19.10 (A5), U20.10 (A5), U21.10 (A5), U22.10 (A5), U23.10 (A5)
/MEM/E6: R25.1, U16.13 (A6), U17.13 (A6), U18.13 (A6), U19.13 (A6), U20.13 (A6), U21.13 (A6), U22.13 (A6), U23.13 (A6)
/MEM/U27P15: U24.12 (Zd), U27.15 (Eb2)
/MEM/~M1CS: RN1.9 (R8), U7.18 (~EP), U26.1 (Q0)
/MEM/~M2CS: RN1.8 (R7), U8.18 (~EP), U26.2 (Q1)
/MEM/~M3CS: RN1.7 (R6), U9.18 (~EP), U26.3 (Q2)
/MEM/~M4CS: RN1.6 (R5), U10.18 (~EP), U26.4 (Q3)
/MEM/~M5CS: RN1.5 (R4), U11.18 (~EP), U26.5 (Q4)
/MEM/~M6CS: RN1.4 (R3), U12.20 (~CE), U26.6 (Q5)
/MEM/~M7CS: RN1.3 (R2), U13.18 (~EP), U26.7 (Q6), Z10.1, Z10.2
/MEM/~RAS: R101.2, U16.4 (~RAS), U17.4 (~RAS), U18.4 (~RAS), U19.4 (~RAS), U20.4 (~RAS), U21.4 (~RAS), U22.4 (~RAS), U23.4 (~RAS)
A0: U5.5 (A0), U6.5 (A0), U7.8 (A0), U8.8 (A0), U9.8 (A0), U10.8 (A0), U11.8 (A0), U12.10 (A0), U13.8 (A0), U25.3 (I1a); also elsewhere on the board
A1: U5.6 (A1), U6.6 (A1), U7.7 (A1), U8.7 (A1), U9.7 (A1), U10.7 (A1), U11.7 (A1), U12.9 (A1), U13.7 (A1), U25.6 (I1b); also elsewhere on the board
A2: U5.7 (A2), U6.7 (A2), U7.6 (A2), U8.6 (A2), U9.6 (A2), U10.6 (A2), U11.6 (A2), U12.8 (A2), U13.6 (A2), U25.10 (I1c); also elsewhere on the board
A3: U5.4 (A3), U6.4 (A3), U7.5 (A3), U8.5 (A3), U9.5 (A3), U10.5 (A3), U11.5 (A3), U12.7 (A3), U13.5 (A3), U25.13 (I1d); also elsewhere on the board
A4: U5.3 (A4), U6.3 (A4), U7.4 (A4), U8.4 (A4), U9.4 (A4), U10.4 (A4), U11.4 (A4), U12.6 (A4), U13.4 (A4), U24.3 (I1a); also elsewhere on the board
A5: U5.2 (A5), U6.2 (A5), U7.3 (A5), U8.3 (A5), U9.3 (A5), U10.3 (A5), U11.3 (A5), U12.5 (A5), U13.3 (A5), U24.6 (I1b); also elsewhere on the board
A6: U5.1 (A6), U6.1 (A6), U7.2 (A6), U8.2 (A6), U9.2 (A6), U10.2 (A6), U11.2 (A6), U12.4 (A6), U13.2 (A6), U24.10 (I1c); also elsewhere on the board
A7: U5.17 (A7), U6.17 (A7), U7.1 (A7), U8.1 (A7), U9.1 (A7), U10.1 (A7), U11.1 (A7), U12.3 (A7), U13.1 (A7), U25.2 (I0a); also elsewhere on the board
A8: U5.16 (A8), U6.16 (A8), U7.23 (A8), U8.23 (A8), U9.23 (A8), U10.23 (A8), U11.23 (A8), U12.25 (A8), U13.23 (A8), U25.5 (I0b); also elsewhere on the board
A9: U5.15 (A9), U6.15 (A9), U7.22 (A9), U8.22 (A9), U9.22 (A9), U10.22 (A9), U11.22 (A9), U12.24 (A9), U13.22 (A9), U25.11 (I0c); also elsewhere on the board
A10: U7.19 (A10), U8.19 (A10), U9.19 (A10), U10.19 (A10), U11.19 (A10), U12.21 (A10), U13.19 (A10), U25.14 (I0d), U39.5, U40.5; also elsewhere on the board
A11: U24.2 (I0a), U26.10 (A0), Z7.1, Z9.1; also elsewhere on the board
A12: U12.2 (A12), U24.5 (I0b), U26.11 (A1); also elsewhere on the board
A13: U24.11 (I0c), U26.12 (A2); also elsewhere on the board
A14: U27.13 (A0); also elsewhere on the board
A15: U27.3 (A1); also elsewhere on the board
BD0: R57.1, U5.14 (D0), U7.9 (Q0), U8.9 (Q0), U9.9 (Q0), U10.9 (Q0), U11.9 (Q0), U12.11 (D0), U13.9 (Q0), U16.2 (DIN), U16.14 (DOUT); also elsewhere on the board
BD1: R56.1, U5.13 (D1), U7.10 (Q1), U8.10 (Q1), U9.10 (Q1), U10.10 (Q1), U11.10 (Q1), U12.12 (D1), U13.10 (Q1), U17.2 (DIN), U17.14 (DOUT); also elsewhere on the board
BD2: R55.1, U5.12 (D2), U7.11 (Q2), U8.11 (Q2), U9.11 (Q2), U10.11 (Q2), U11.11 (Q2), U12.13 (D2), U13.11 (Q2), U18.2 (DIN), U18.14 (DOUT); also elsewhere on the board
BD3: R54.1, U5.11 (D3), U7.13 (Q3), U8.13 (Q3), U9.13 (Q3), U10.13 (Q3), U11.13 (Q3), U12.15 (D3), U13.13 (Q3), U19.2 (DIN), U19.14 (DOUT); also elsewhere on the board
BD4: R53.1, U6.14 (D0), U7.14 (Q4), U8.14 (Q4), U9.14 (Q4), U10.14 (Q4), U11.14 (Q4), U12.16 (D4), U13.14 (Q4), U20.2 (DIN), U20.14 (DOUT); also elsewhere on the board
BD5: R52.1, U6.13 (D1), U7.15 (Q5), U8.15 (Q5), U9.15 (Q5), U10.15 (Q5), U11.15 (Q5), U12.17 (D5), U13.15 (Q5), U21.2 (DIN), U21.14 (DOUT); also elsewhere on the board
BD6: R51.1, U6.12 (D2), U7.16 (Q6), U8.16 (Q6), U9.16 (Q6), U10.16 (Q6), U11.16 (Q6), U12.18 (D6), U13.16 (Q6), U22.2 (DIN), U22.14 (DOUT); also elsewhere on the board
BD7: R50.1, U6.11 (D3), U7.17 (Q7), U8.17 (Q7), U9.17 (Q7), U10.17 (Q7), U11.17 (Q7), U12.19 (D7), U13.17 (Q7), U23.2 (DIN), U23.14 (DOUT); also elsewhere on the board
GND: C10.2, U5.9 (GND), U6.9 (GND), U7.12 (GND), U8.12 (GND), U9.12 (GND), U10.12 (GND), U11.12 (GND), U12.14 (GND), U13.12 (GND), U16.16 (VSS), U17.16 (VSS), U18.16 (VSS), U19.16 (VSS), U20.16 (VSS), U21.16 (VSS), U22.16 (VSS), U23.16 (VSS), U24.8 (GND), U24.14 (I0d), U24.15 (E), U25.8 (GND), U25.15 (E), U26.8 (GND), U26.13 (A3), U26.14 (A4), U27.8 (GND); also elsewhere on the board
unnamed: C10.1, D2.2 (A), R41.2, U41.2
unnamed: D2.1 (K), R41.1, U40.2, U40.13
unnamed: RN1.2 (R1), U26.9 (Q7), U39.1, U39.4
unnamed: R101.1, T7.1 (Pin_1_1), U40.12
unnamed: R22.2, U12.27 (~PGM)
unnamed: R18.1, U24.13 (I1d)
unnamed: U24.1 (S), U25.1 (S), U41.3
unnamed: R27.2, U24.4 (Za)
unnamed: R26.2, U24.7 (Zb)
unnamed: R25.2, U24.9 (Zc)
unnamed: R31.2, U25.4 (Za)
unnamed: R30.2, U25.7 (Zb)
unnamed: R29.2, U25.9 (Zc)
unnamed: R28.2, U25.12 (Zd)
unnamed: U27.9 (Q0b), Z14.7
unnamed: U27.10 (Q1b), Z14.5
unnamed: U27.5 (Q2a), Z8.4
unnamed: U27.11 (Q2b), Z14.3
unnamed: U27.4 (Q3a), Z8.2
unnamed: U39.2, U40.6
RD: U5.10 (~WE), U6.10 (~WE), U16.3 (~WRITE), U17.3 (~WRITE), U18.3 (~WRITE), U19.3 (~WRITE), U20.3 (~WRITE), U21.3 (~WRITE), U22.3 (~WRITE), U23.3 (~WRITE); also elsewhere on the board
~CAS: R100.1, U16.15 (~CAS), U17.15 (~CAS), U18.15 (~CAS), U19.15 (~CAS), U20.15 (~CAS), U21.15 (~CAS), U22.15 (~CAS), U23.15 (~CAS)
~KL: T9.1 (Pin_1_1), U39.6; also elsewhere on the board
~MREQ: U27.2 (Ea2), U27.14 (Eb1), U40.1; also elsewhere on the board
~RAMSEL: R100.2, T6.1 (Pin_1_1), U27.12 (Q3b), Z14.1, Z14.2, Z14.4, Z14.6, Z14.8; also elsewhere on the board
~RAMS: T5.1 (Pin_1_1), U5.8 (~CS), U6.8 (~CS), U27.6 (Q1a), Z8.1, Z8.3, Z8.5, Z8.6; also elsewhere on the board
~RD: U7.20 (~G), U8.20 (~G), U9.20 (~G), U10.20 (~G), U11.20 (~G), U12.22 (~OE), U13.20 (~G); also elsewhere on the board
~RFSH: U27.1 (Ea1), U41.1; also elsewhere on the board
~ROM: T4.1 (Pin_1_1), U26.15 (~G), U27.7 (Q0a), Z8.7, Z8.8; also elsewhere on the board
~VID: T8.1 (Pin_1_1), U39.3; also elsewhere on the board
~WR: Z7.5, Z9.5; also elsewhere on the board

Notes on the sheet:
EMPTY

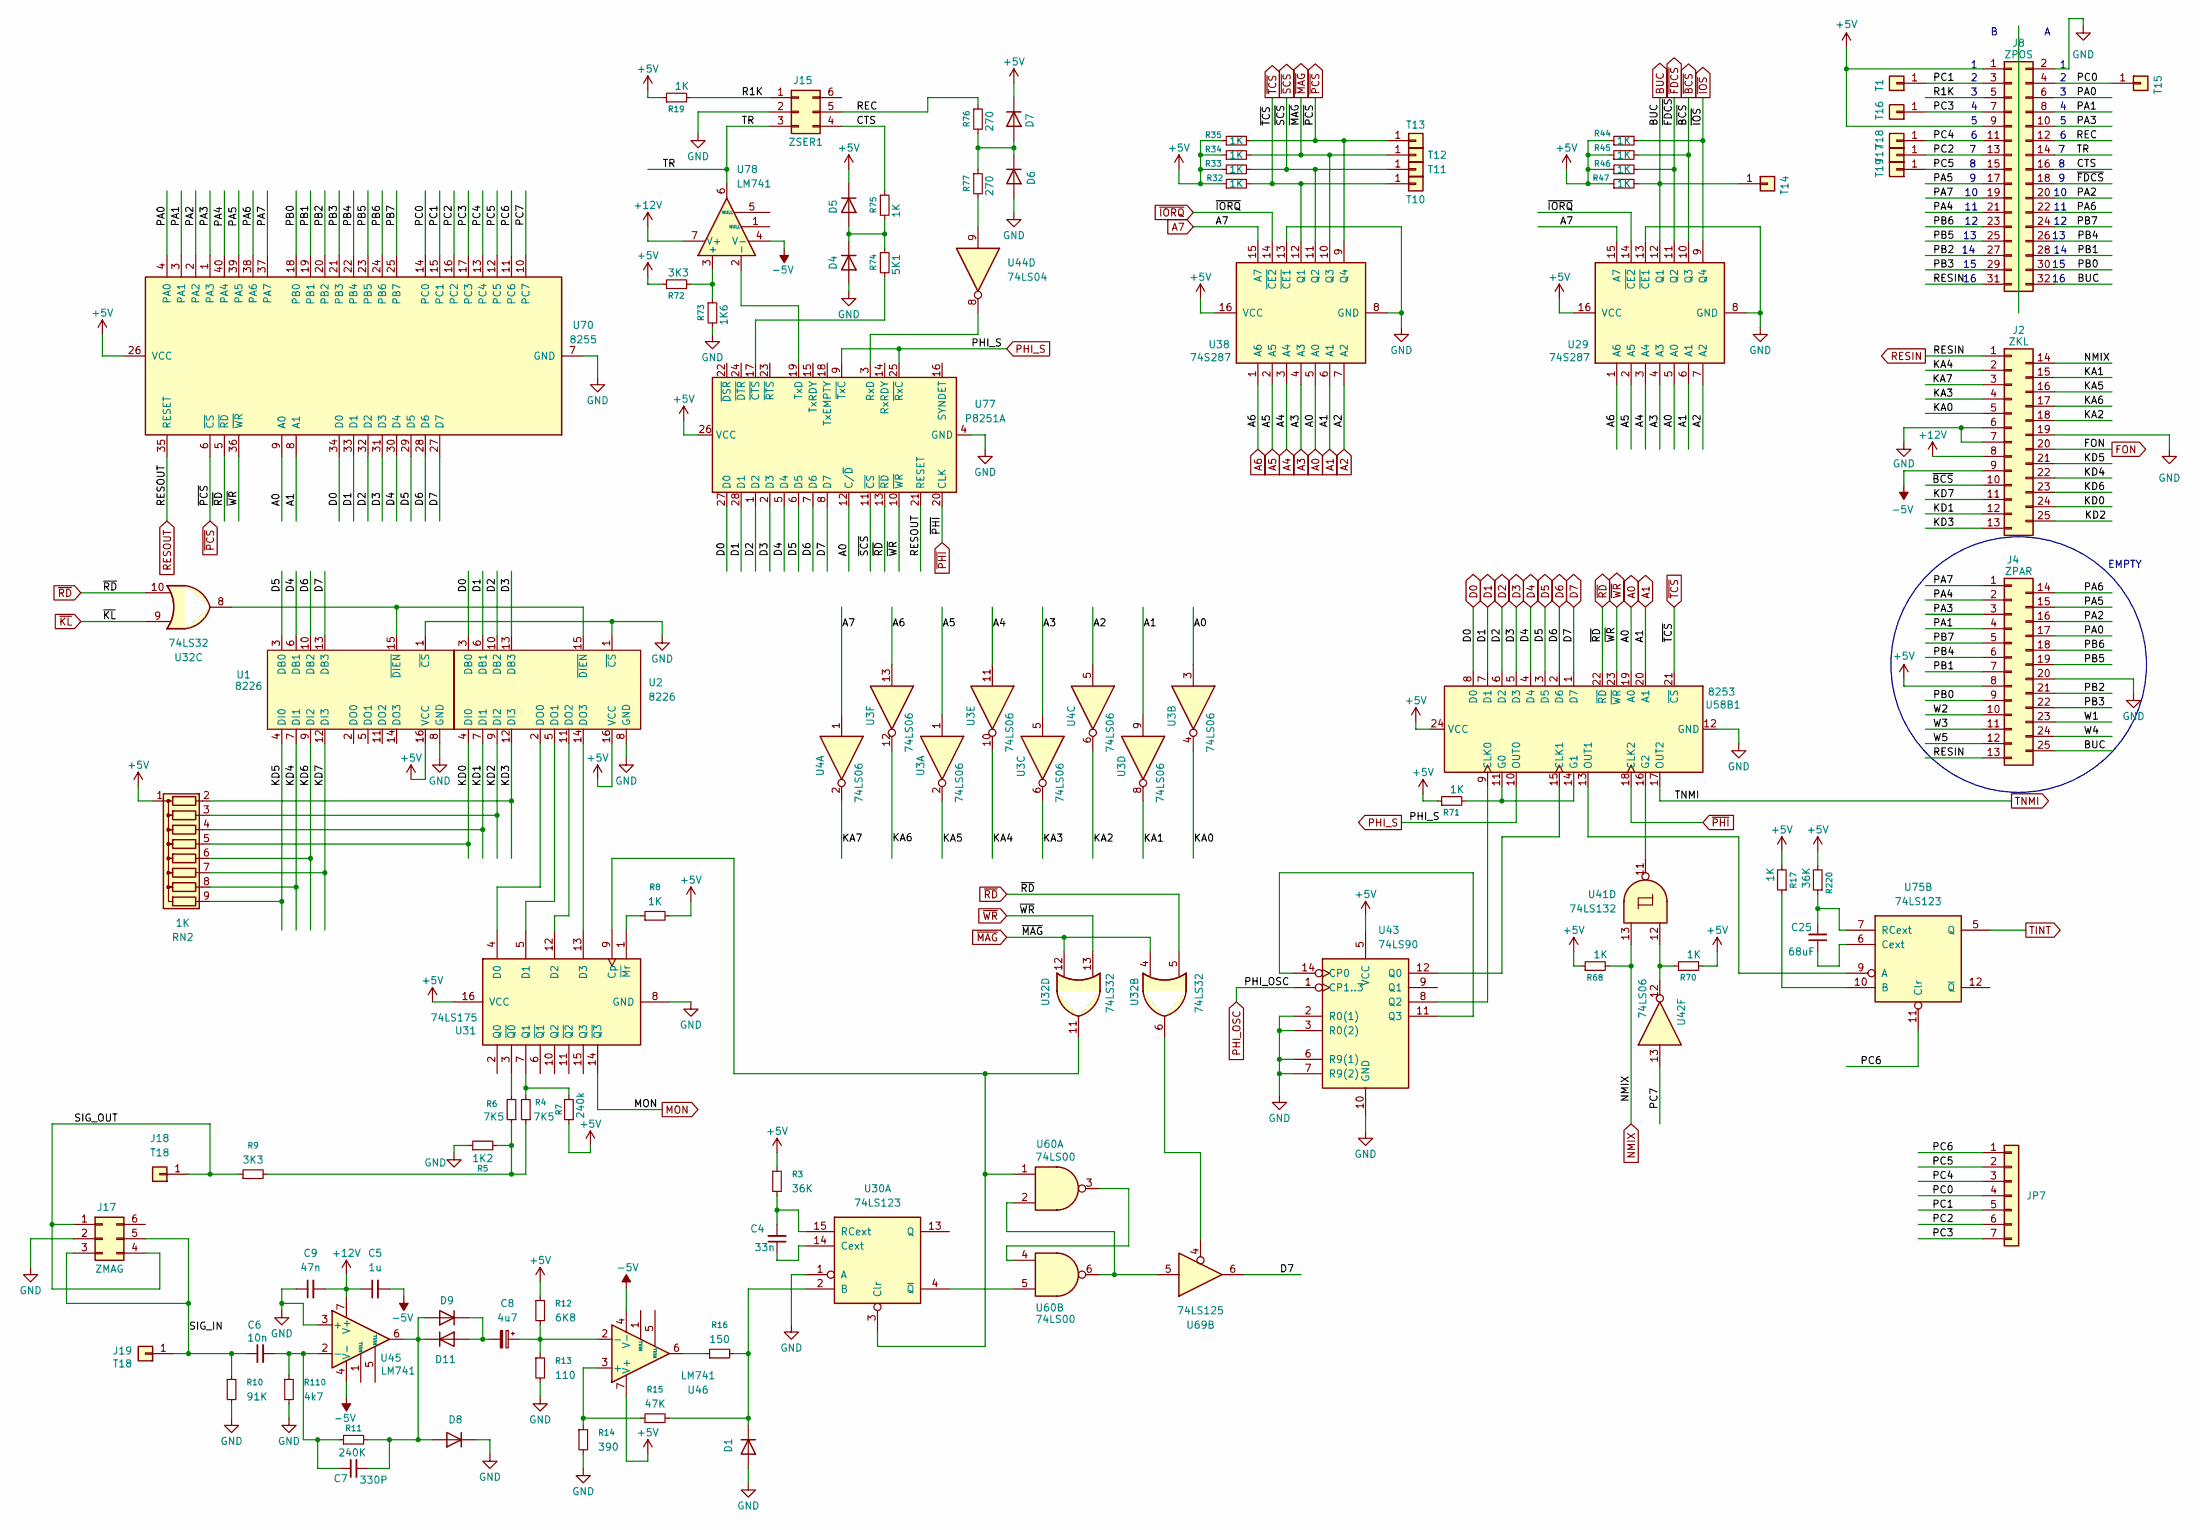
[picture p26: schematic Interface.kicad_sch, KOMPUTER MERITUM-1]

Parts:
C4: 33n; c_200
C5: 1u; c_200
C6: 10n; C_Rect_L4.0mm_W2.5mm_P2.50mm
C7: 330P; c_100
C8: 4u7; c_200
C9: 47n; c_200
C25: 68uF; CP_Radial_D5.0mm_P2.50mm
D1: 1N4148; D_DO-35_SOD27_P10.16mm_Horizontal
D4, D5: 1N4148WT; D_DO-35_SOD27_P2.54mm_Vertical_KathodeUp
D6, D7: 1N4148WT; D_DO-35_SOD27_P10.16mm_Horizontal
D8, D9, D11: 1N4148; D_DO-35_SOD27_P5.08mm_Vertical_AnodeUp
J2: ZKL; PinSocket_25_P2.54mm_Vertical
J4: ZPAR; PinSocket_25_P2.54mm_Vertical
J8: ZPOS; PinSocket_2x16_P2.54mm_Vertical_Meritum
J15: ZSER1; PinHeader_2x03_P2.54mm_Vertical
J17: ZMAG; PinHeader_2x03_P2.54mm_Vertical
J18, J19: T18; pin
JP7: Conn_01x07; PinHeader_1x07_P2.54mm_Vertical
R3, R220: 36K; r_400
R4, R6: 7K5; r_400
R5: 1K2; r_400
R7: 240k; r_400
R8, R17, R19, R32, R33, R34, R35, R44, R45, R46, R47, R68, R70, R75: 1K; r_400
R9, R72: 3K3; r_400
R10: 91K; R_Axial_DIN0207_L6.3mm_D2.5mm_P2.54mm_Vertical
R11: 240K; r_400
R12: 6K8; r_400
R13: 110; r_400
R14: 390; r_400
R15: 47K; r_400
R16: 150; r_400
R71: 1K; R_Axial_DIN0207_L6.3mm_D2.5mm_P2.54mm_Vertical
R73: 1K6; r_400
R74: 5K1; r_400
R76, R77: 270; r_400
R110: 4k7; R_Axial_DIN0207_L6.3mm_D2.5mm_P5.08mm_Vertical
RN2: 1K; R_Array_SIP9
T1, T10, T11, T12, T13, T14, T15, T16, T17, T18, T19: T18; pin
U1, U2: 8226; DIP-16_W7.62mm_LongPads
U3, U4, U42: 74LS06; DIP-14_W7.62mm_LongPads
U29, U38: 74S287; DIP-16_W7.62mm_LongPads
U30, U75: 74LS123; DIP-16_W7.62mm_LongPads
U31: 74LS175; DIP-16_W7.62mm_LongPads
U32: 74LS32; DIP-14_W7.62mm_LongPads
U41: 74LS132; DIP-14_W7.62mm_LongPads
U43: 74LS90; DIP-14_W7.62mm_LongPads
U44: 74LS04; DIP-14_W7.62mm_LongPads
U45, U46, U78: LM741; DIP-8_W7.62mm_LongPads
U58B1: 8253; DIP-24_W15.24mm_LongPads
U60: 74LS00; DIP-14_W7.62mm_LongPads
U69: 74LS125; DIP-14_W7.62mm_LongPads
U70: 8255; DIP-40_W15.24mm_LongPads
U77: P8251A; DIP-28_W15.24mm

Connections:
+5V: D5.1 (K), D7.1 (K), J4.8, J8.1, J8.9, R3.1, R7.1, R8.2, R12.1, R17.2, R19.1, R32.1, R33.1, R34.1, R35.1, R44.1, R45.1, R46.1, R47.1, R68.1, R70.2, R71.1, R72.1, R220.2, RN2.1 (common), U1.16 (VCC), U2.16 (VCC), U29.16 (VCC), U31.16 (VCC), U38.16 (VCC), U43.5 (VCC), U46.7 (V+), U58B1.24 (VCC), U70.26 (VCC), U77.26 (VCC); also elsewhere on the board
+12V: C5.1, C9.2, J2.8, U45.7 (V+), U78.7 (V+); also elsewhere on the board
-5V: C5.2, J2.9, U45.4 (V-), U46.4 (V-), U78.4 (V-); also elsewhere on the board
/Interface/CTS: J8.16, J15.4, R75.1
/Interface/KA0: J2.5, U3.4
/Interface/KA1: J2.15, U3.8
/Interface/KA2: J2.18, U4.6
/Interface/KA3: J2.4, U3.6
/Interface/KA4: J2.2, U3.10
/Interface/KA5: J2.16, U3.2
/Interface/KA6: J2.17, U3.12
/Interface/KA7: J2.3, U4.2
/Interface/KD0: J2.24, RN2.5 (R4), U2.4 (DI0)
/Interface/KD1: J2.12, RN2.4 (R3), U2.7 (DI1)
/Interface/KD2: J2.25, RN2.3 (R2), U2.9 (DI2)
/Interface/KD3: J2.13, RN2.2 (R1), U2.12 (DI3)
/Interface/KD4: J2.22, RN2.8 (R7), U1.7 (DI1)
/Interface/KD5: J2.21, RN2.9 (R8), U1.4 (DI0)
/Interface/KD6: J2.23, RN2.6 (R5), U1.9 (DI2)
/Interface/KD7: J2.11, RN2.7 (R6), U1.12 (DI3)
/Interface/PA0: J4.17, J8.6, U70.4 (PA0)
/Interface/PA1: J4.4, J8.8, U70.3 (PA1)
/Interface/PA2: J4.16, J8.20, U70.2 (PA2)
/Interface/PA3: J4.3, J8.10, U70.1 (PA3)
/Interface/PA4: J4.2, J8.21, U70.40 (PA4)
/Interface/PA5: J4.15, J8.17, U70.39 (PA5)
/Interface/PA6: J4.14, J8.22, U70.38 (PA6)
/Interface/PA7: J4.1, J8.19, U70.37 (PA7)
/Interface/PB0: J4.9, J8.30, U70.18 (PB0)
/Interface/PB1: J4.7, J8.28, U70.19 (PB1)
/Interface/PB2: J4.21, J8.27, U70.20 (PB2)
/Interface/PB3: J4.22, J8.29, U70.21 (PB3)
/Interface/PB4: J4.6, J8.26, U70.22 (PB4)
/Interface/PB5: J4.19, J8.25, U70.23 (PB5)
/Interface/PB6: J4.18, J8.23, U70.24 (PB6)
/Interface/PB7: J4.5, J8.24, U70.25 (PB7)
/Interface/PC0: J8.4, JP7.4, T15.1 (Pin_1_1), U70.14 (PC0)
/Interface/PC1: J8.3, JP7.5, T1.1 (Pin_1_1), U70.15 (PC1)
/Interface/PC2: J8.13, JP7.6, T17.1 (Pin_1_1), U70.16 (PC2)
/Interface/PC3: J8.7, JP7.7, T16.1 (Pin_1_1), U70.17 (PC3)
/Interface/PC4: J8.11, JP7.3, T18.1 (Pin_1_1), U70.13 (PC4)
/Interface/PC5: J8.15, JP7.2, T19.1 (Pin_1_1), U70.12 (PC5)
/Interface/PC6: JP7.1, U70.11 (PC6), U75.11 (Clr)
/Interface/PC7: U42.13, U70.10 (PC7)
/Interface/R1K: J8.5, J15.1, R19.2
/Interface/REC: J8.12, J15.5, R76.1
/Interface/SIG_IN: C6.1, J17.3, J17.5, J19.1 (Pin_1_1), R10.1
/Interface/SIG_OUT: J17.1, J17.4, J18.1 (Pin_1_1), R9.1
/Interface/TR: J8.14, J15.3, U78.6
/Interface/W1: J4.23
/Interface/W2: J4.10
/Interface/W3: J4.11
/Interface/W4: J4.24
/Interface/W5: J4.12
A0: U3.3, U29.5 (A0), U38.5 (A0), U58B1.19 (A0), U70.9 (A0), U77.12 (C/~D); also elsewhere on the board
A1: U3.9, U29.6 (A1), U38.6 (A1), U58B1.20 (A1), U70.8 (A1); also elsewhere on the board
A2: U4.5, U29.7 (A2), U38.7 (A2); also elsewhere on the board
A3: U3.5, U29.4 (A3), U38.4 (A3); also elsewhere on the board
A4: U3.11, U29.3 (A4), U38.3 (A4); also elsewhere on the board
A5: U3.1, U29.2 (A5), U38.2 (A5); also elsewhere on the board
A6: U3.13, U29.1 (A6), U38.1 (A6); also elsewhere on the board
A7: U4.1, U29.15 (A7), U38.15 (A7); also elsewhere on the board
BD0: U2.3 (DB0), U58B1.8 (D0), U70.34 (D0), U77.27 (D0); also elsewhere on the board
BD1: U2.6 (DB1), U58B1.7 (D1), U70.33 (D1), U77.28 (D1); also elsewhere on the board
BD2: U2.10 (DB2), U58B1.6 (D2), U70.32 (D2), U77.1 (D2); also elsewhere on the board
BD3: U2.13 (DB3), U58B1.5 (D3), U70.31 (D3), U77.2 (D3); also elsewhere on the board
BD4: U1.6 (DB1), U58B1.4 (D4), U70.30 (D4), U77.5 (D4); also elsewhere on the board
BD5: U1.3 (DB0), U58B1.3 (D5), U70.29 (D5), U77.6 (D5); also elsewhere on the board
BD6: U1.10 (DB2), U58B1.2 (D6), U70.28 (D6), U77.7 (D6); also elsewhere on the board
BD7: U1.13 (DB3), U58B1.1 (D7), U69.6, U70.27 (D7), U77.8 (D7); also elsewhere on the board
BUC: J4.25, J8.32, R47.2, T14.1 (Pin_1_1), U29.12 (Q1)
FON: J2.20; also elsewhere on the board
GND: C9.1, D1.2 (A), D4.2 (A), D6.2 (A), D8.1 (K), J2.6, J2.7, J2.19, J4.20, J8.2, J15.2, J17.2, R5.1, R10.2, R13.2, R14.2, R73.2, R110.2, U1.1 (~CS), U1.8 (GND), U2.1 (~CS), U2.8 (GND), U29.8 (GND), U29.13 (~CE1), U30.1 (A), U31.8 (GND), U38.8 (GND), U38.13 (~CE1), U43.2 (R0(1)), U43.3 (R0(2)), U43.6 (R9(1)), U43.7 (R9(2)), U43.10 (GND), U45.3 (+), U58B1.12 (GND), U70.7 (GND), U77.4 (GND); also elsewhere on the board
MON: U31.14 (~Q3); also elsewhere on the board
NMIX: J2.14, R68.2, U41.13
unnamed: D1.1 (K), R15.2, R16.2, U30.2 (B)
unnamed: D4.1 (K), D5.2 (A), R74.1, R75.2
unnamed: D6.1 (K), D7.2 (A), R76.2, R77.1
unnamed: C8.2, D9.1 (K), D11.2 (A)
unnamed: C7.2, D8.2 (A), D9.2 (A), D11.1 (K), R11.2, U45.6
unnamed: R4.1, R5.2, R6.1, R9.2
unnamed: R16.1, U46.6
unnamed: R70.1, U41.12, U42.12
unnamed: R77.2, U44.9
unnamed: U1.15 (~DIEN), U2.15 (~DIEN), U32.8
unnamed: U2.2 (DO0), U31.4 (D0)
unnamed: U2.5 (DO1), U31.5 (D1)
unnamed: U2.11 (DO2), U31.12 (D2)
unnamed: U2.14 (DO3), U31.13 (D3)
unnamed: C4.1, U30.14 (Cext)
unnamed: U30.3 (Clr), U31.9 (Cp), U32.11, U60.1
unnamed: C4.2, R3.2, U30.15 (RCext)
unnamed: U30.4 (~Q), U60.5
unnamed: R4.2, R7.2, U31.7 (Q1)
unnamed: R8.1, U31.1 (~Mr)
unnamed: R6.2, U31.3 (~Q0)
unnamed: U32.6, U69.4
unnamed: U43.11 (Q3), U43.14 (CP0)
unnamed: U43.12 (Q0), U58B1.15 (CLK1)
unnamed: U43.8 (Q2), U58B1.9 (CLK0)
unnamed: C6.2, C7.1, R11.1, R110.1, U45.2 (-)
unnamed: R14.1, R15.1, U46.3 (+)
unnamed: C8.1, R12.2, R13.1, U46.2 (-)
unnamed: R71.2, U58B1.11 (G0), U58B1.14 (G1)
unnamed: U41.11, U58B1.16 (G2)
unnamed: U58B1.13 (OUT1), U75.9 (A)
unnamed: U60.2, U60.6, U69.5
unnamed: U60.3, U60.4
unnamed: R17.1, U75.10 (B)
unnamed: C25.1, U75.6 (Cext)
unnamed: C25.2, R220.1, U75.7 (RCext)
unnamed: U44.8, U77.3 (RxD)
unnamed: U77.19 (TxD), U78.2 (-)
unnamed: R74.2, U77.17 (~CTS)
unnamed: R72.2, R73.1, U78.3 (+)
PHI_OSC: U43.1 (CP1..3); also elsewhere on the board
PHI_S: U58B1.10 (OUT0), U77.9 (~TxC), U77.25 (~RxC)
RESIN: J2.1, J4.13, J8.31; also elsewhere on the board
RESOUT: U70.35 (RESET), U77.21 (RESET); also elsewhere on the board
TINT: U75.5 (Q); also elsewhere on the board
TNMI: U58B1.17 (OUT2); also elsewhere on the board
~BCS: J2.10, R45.2, U29.10 (Q3)
~FDCS: J8.18, R46.2, U29.11 (Q2)
~IORQ: U29.14 (~CE2), U38.14 (~CE2); also elsewhere on the board
~IOS: R44.2, U29.9 (Q4); also elsewhere on the board
~KL: U32.9; also elsewhere on the board
~MAG: R34.2, T12.1 (Pin_1_1), U32.4, U32.12, U38.10 (Q3)
~PCS: R35.2, T13.1 (Pin_1_1), U38.9 (Q4), U70.6 (~CS)
~PHI: U58B1.18 (CLK2), U77.20 (CLK); also elsewhere on the board
~RD: U32.5, U32.10, U58B1.22 (~RD), U70.5 (~RD), U77.13 (~RD); also elsewhere on the board
~SCS: R33.2, T11.1 (Pin_1_1), U38.11 (Q2), U77.11 (~CS)
~TCS: R32.2, T10.1 (Pin_1_1), U38.12 (Q1), U58B1.21 (~CS)
~WR: U32.13, U58B1.23 (~WR), U70.36 (~WR), U77.10 (~WR); also elsewhere on the board

Notes on the sheet:
EMPTY

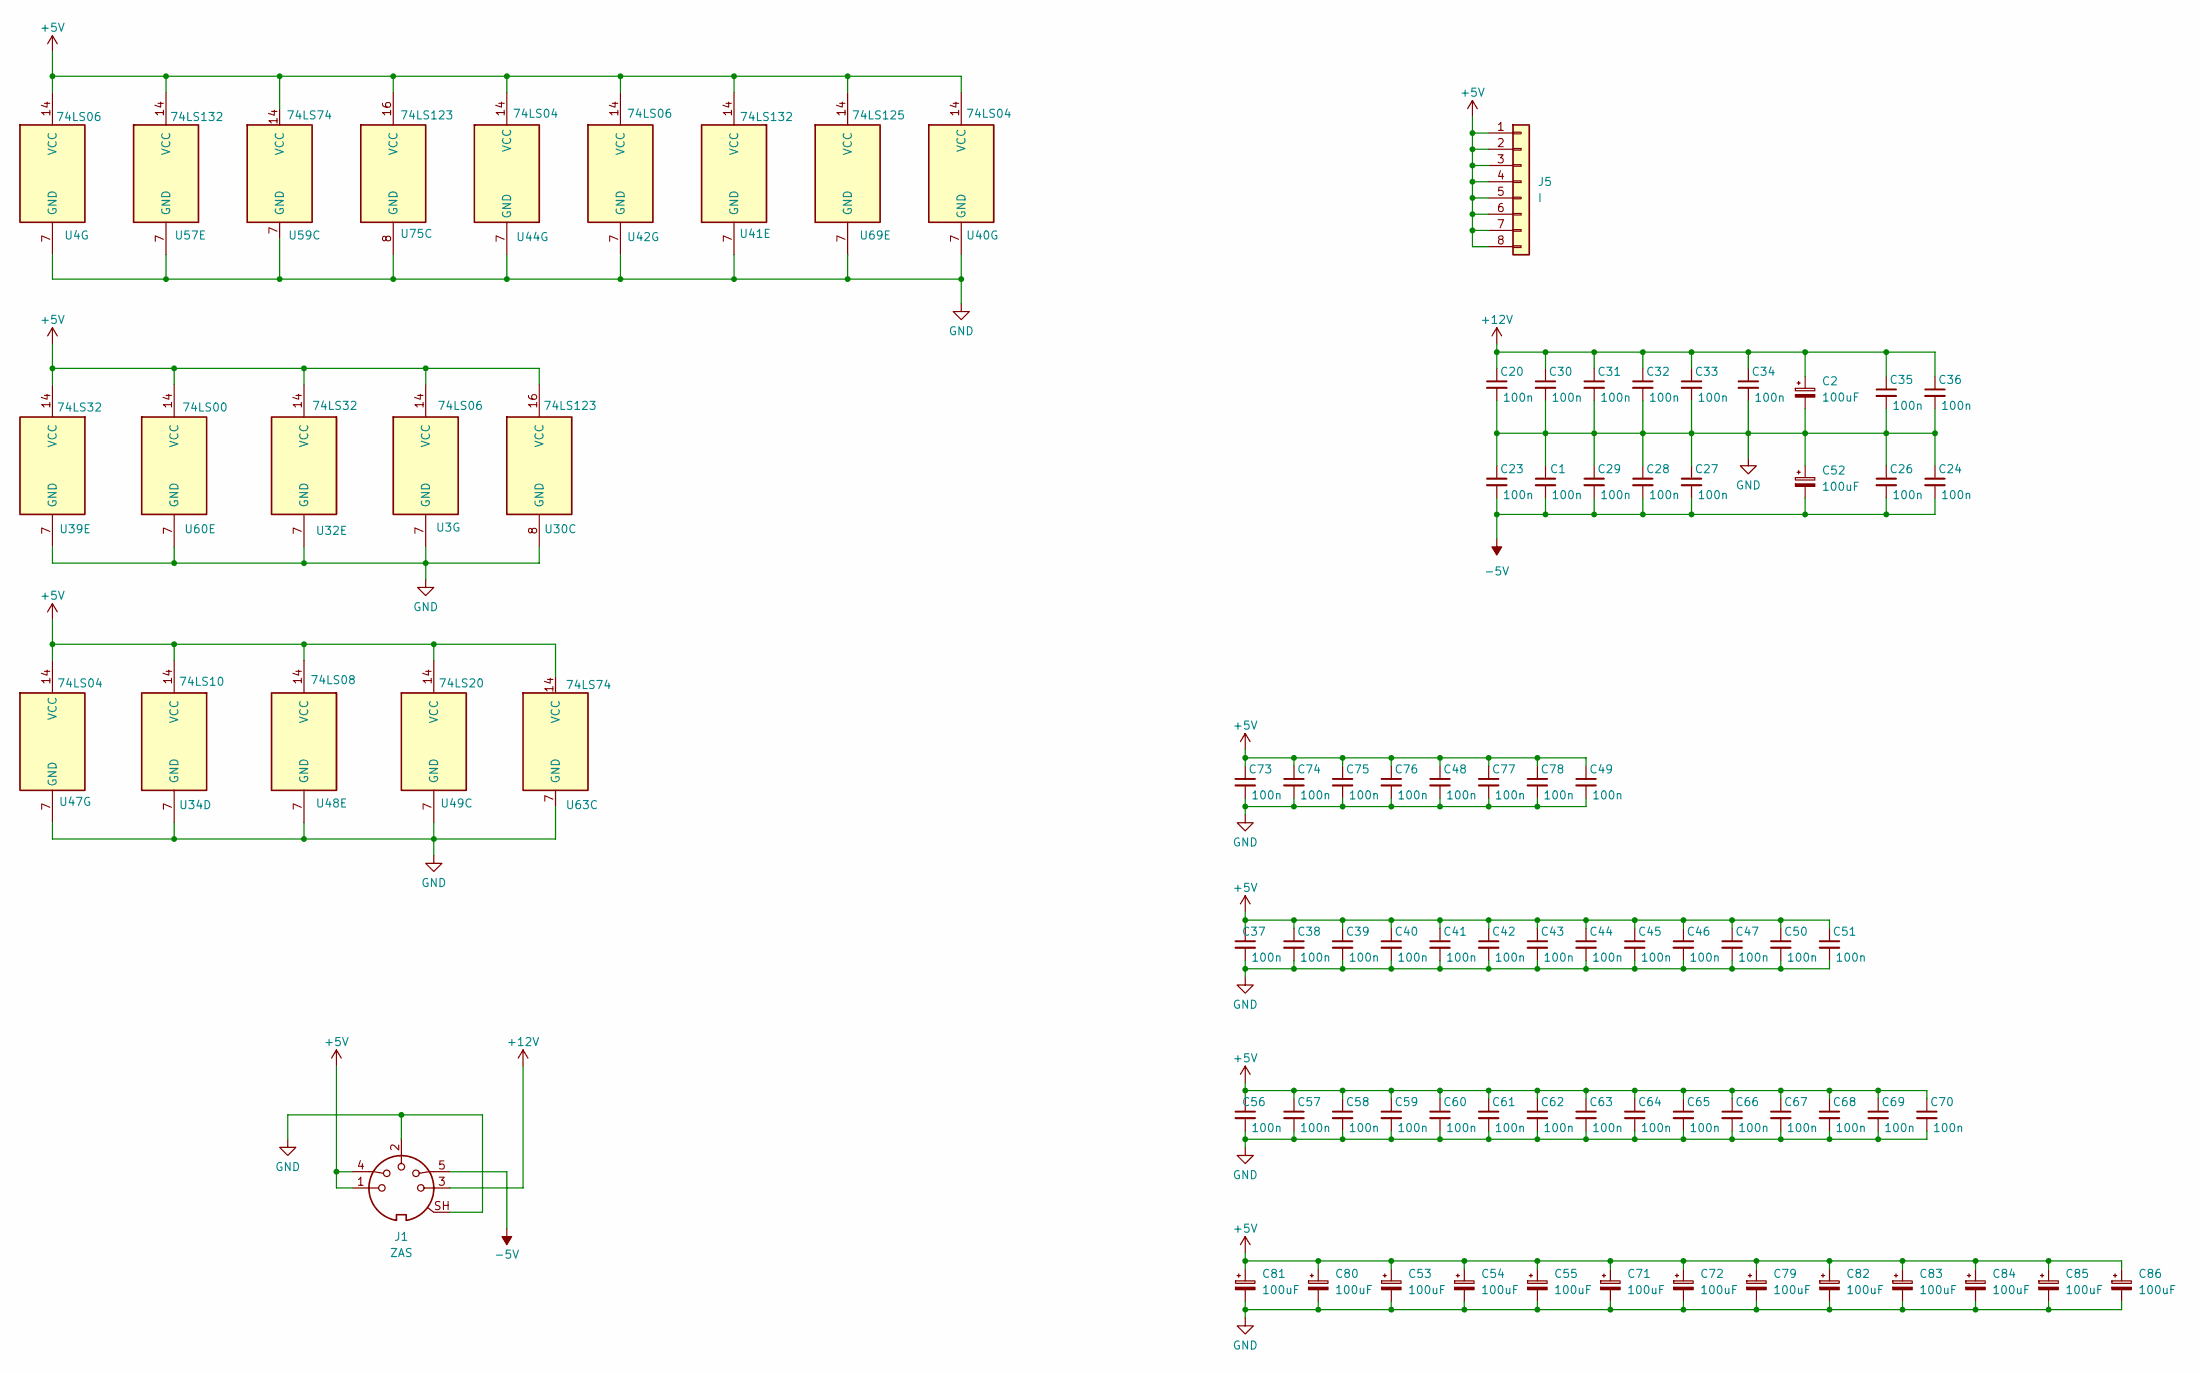
[picture p27: schematic Power.kicad_sch, KOMPUTER MERITUM-1]

Parts:
C1, C20, C23, C24, C26, C27, C28, C29, C30, C31, C32, C33, C34, C35, C36, C37, C38, C39, C40, C41, C42, C43, C44, C45, C46, C47, C50, C51, C56, C57, C58, C59, C60, C61, C62, C63, C64, C65, C66, C67, C68, C69, C70, C73, C74, C75, C76: 100n; c_200
C2, C52, C53, C54, C55, C71, C72, C79, C80, C81, C82, C83, C84, C85, C86: 100uF; CP_Radial_D5.0mm_P2.50mm
C48, C49, C77, C78: 100n; c_100
J1: ZAS; CUI_SDS-50J
J5: I; PinHeader_1x08_P2.54mm_Vertical
U3, U4, U42: 74LS06; DIP-14_W7.62mm_LongPads
U30, U75: 74LS123; DIP-16_W7.62mm_LongPads
U32, U39: 74LS32; DIP-14_W7.62mm_LongPads
U34: 74LS10; DIP-14_W7.62mm_LongPads
U40, U44, U47: 74LS04; DIP-14_W7.62mm_LongPads
U41, U57: 74LS132; DIP-14_W7.62mm_LongPads
U48: 74LS08; DIP-14_W7.62mm_LongPads
U49: 74LS20; DIP-14_W7.62mm_LongPads
U59, U63: 74LS74; DIP-14_W7.62mm_LongPads
U60: 74LS00; DIP-14_W7.62mm_LongPads
U69: 74LS125; DIP-14_W7.62mm_LongPads

Connections:
+5V: C37.1, C38.1, C39.1, C40.1, C41.1, C42.1, C43.1, C44.1, C45.1, C46.1, C47.1, C48.1, C49.1, C50.1, C51.1, C53.1, C54.1, C55.1, C56.1, C57.1, C58.1, C59.1, C60.1, C61.1, C62.1, C63.1, C64.1, C65.1, C66.1, C67.1, C68.1, C69.1, C70.1, C71.1, C72.1, C73.1, C74.1, C75.1, C76.1, C77.1, C78.1, C79.1, C80.1, C81.1, C82.1, C83.1, C84.1, C85.1, C86.1, J1.1, J1.4, J5.1, J5.2, J5.3, J5.4, J5.5, J5.6, J5.7, J5.8, U3.14 (VCC), U4.14 (VCC), U30.16 (VCC), U32.14 (VCC), U34.14 (VCC), U39.14 (VCC), U40.14 (VCC), U41.14 (VCC), U42.14 (VCC), U44.14 (VCC), U47.14 (VCC), U48.14 (VCC), U49.14 (VCC), U57.14 (VCC), U59.14 (VCC), U60.14 (VCC), U63.14 (VCC), U69.14 (VCC), U75.16 (VCC); also elsewhere on the board
+12V: C2.1, C20.1, C30.1, C31.1, C32.1, C33.1, C34.1, C35.1, C36.1, J1.3; also elsewhere on the board
-5V: C1.2, C23.2, C24.2, C26.2, C27.2, C28.2, C29.2, C52.2, J1.5; also elsewhere on the board
GND: C1.1, C2.2, C20.2, C23.1, C24.1, C26.1, C27.1, C28.1, C29.1, C30.2, C31.2, C32.2, C33.2, C34.2, C35.2, C36.2, C37.2, C38.2, C39.2, C40.2, C41.2, C42.2, C43.2, C44.2, C45.2, C46.2, C47.2, C48.2, C49.2, C50.2, C51.2, C52.1, C53.2, C54.2, C55.2, C56.2, C57.2, C58.2, C59.2, C60.2, C61.2, C62.2, C63.2, C64.2, C65.2, C66.2, C67.2, C68.2, C69.2, C70.2, C71.2, C72.2, C73.2, C74.2, C75.2, C76.2, C77.2, C78.2, C79.2, C80.2, C81.2, C82.2, C83.2, C84.2, C85.2, C86.2, J1.2, J1.SH, U3.7 (GND), U4.7 (GND), U30.8 (GND), U32.7 (GND), U34.7 (GND), U39.7 (GND), U40.7 (GND), U41.7 (GND), U42.7 (GND), U44.7 (GND), U47.7 (GND), U48.7 (GND), U49.7 (GND), U57.7 (GND), U59.7 (GND), U60.7 (GND), U63.7 (GND), U69.7 (GND), U75.8 (GND); also elsewhere on the board
