dariusz-majchrzak/Meritum-2/Meritum2_PGW/kicad/Meritum_PGW.kicad_pcb

## KiCad design Meritum2_PGW/kicad/Meritum_PGW.kicad_pcb (continued)

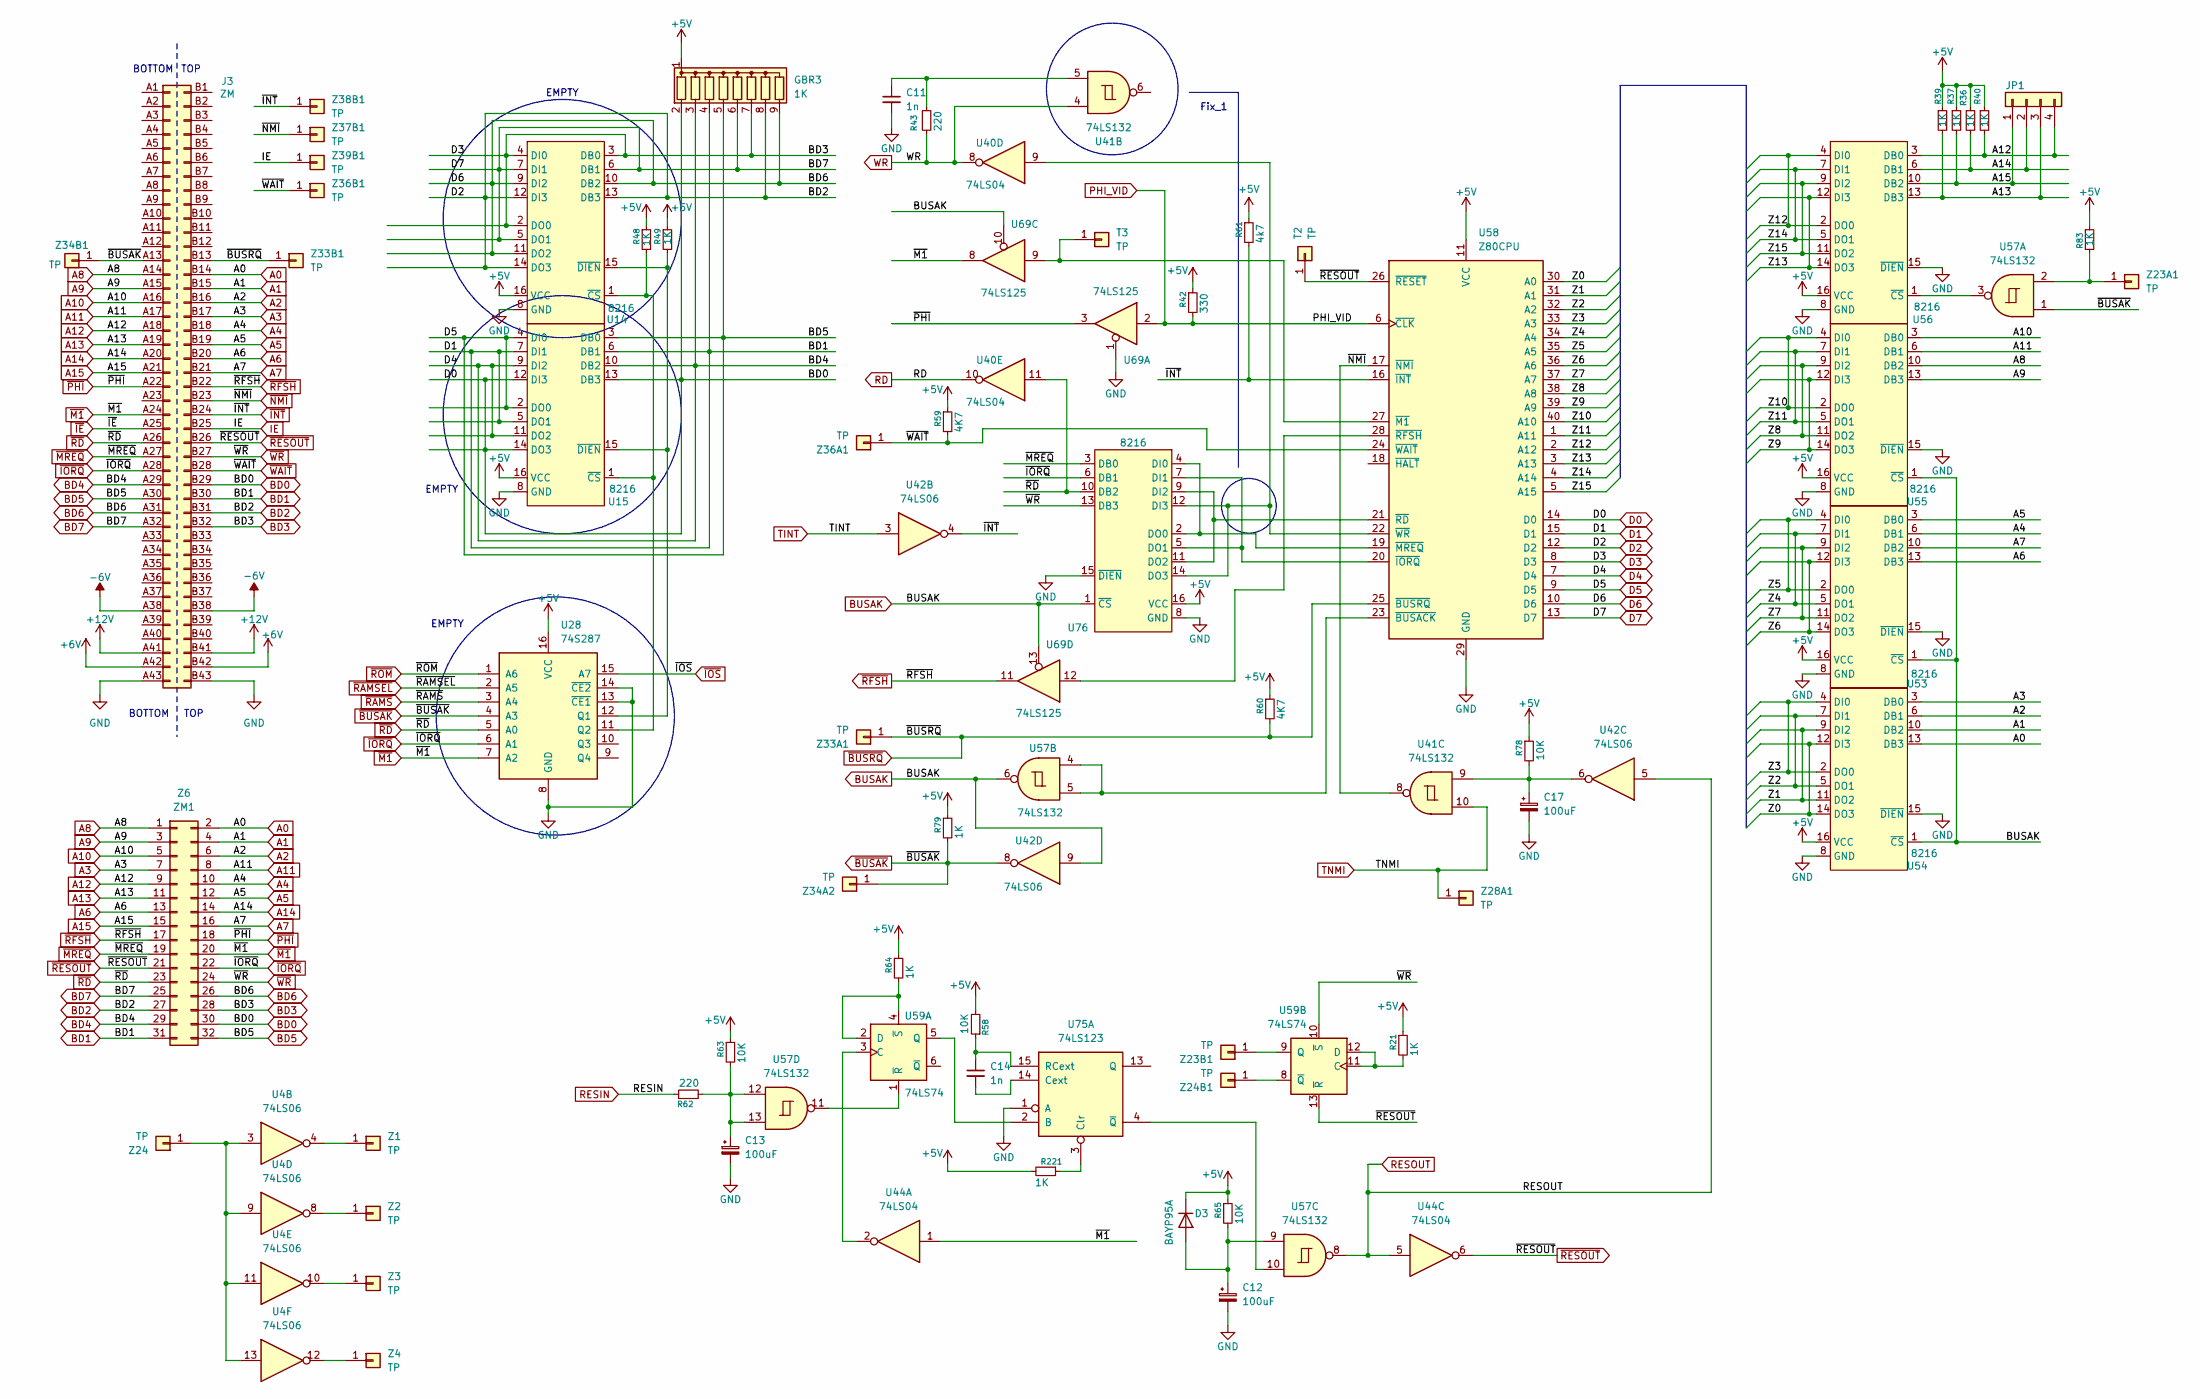
[picture p28: schematic CPU.kicad_sch, KOMPUTER MERITUM-1]

Parts:
C11, C14: 1n; c_200
C12, C13, C17: 100uF; CP_Radial_D5.0mm_P2.50mm
D3: BAYP95A; D_DO-35_SOD27_P10.16mm_Horizontal
GBR3: 1K; R_Array_SIP9
J3: ZM; Meritum_ZM
JP1: Conn_01x04; PinHeader_1x04_P2.54mm_Vertical
R21, R36, R37, R39, R40, R48, R49, R64, R79, R83, R221: 1K; r_400
R42: 330; r_400
R43, R62: 220; r_400
R58, R63, R65, R78: 10K; r_400
R59, R60: 4K7; r_400
R61: 4k7; r_400
T2, T3: TP; pin
U4, U42: 74LS06; DIP-14_W7.62mm_LongPads
U14, U15, U53, U54, U55, U56, U76: 8216; DIP-16_W7.62mm_LongPads
U28: 74S287; DIP-16_W7.62mm_LongPads
U40, U44: 74LS04; DIP-14_W7.62mm_LongPads
U41, U57: 74LS132; DIP-14_W7.62mm_LongPads
U58: Z80CPU; DIP-40_W15.24mm_LongPads
U59: 74LS74; DIP-14_W7.62mm_LongPads
U69: 74LS125; DIP-14_W7.62mm_LongPads
U75: 74LS123; DIP-16_W7.62mm_LongPads
Z1, Z2, Z3, Z4, Z23A1, Z23B1, Z24, Z24B1, Z28A1, Z33A1, Z33B1, Z34A2, Z34B1, Z36A1, Z36B1, Z37B1, Z38B1, Z39B1: TP; pin
Z6: ZM1; PinSocket_2x16_P2.54mm_Vertical_Meritum

Connections:
+5V: D3.1 (K), GBR3.1 (common), R21.1, R36.1, R37.1, R39.1, R40.1, R42.1, R48.1, R49.1, R58.2, R59.1, R60.1, R61.1, R63.1, R64.1, R65.1, R78.1, R79.1, R83.1, R221.2, U14.16 (VCC), U15.16 (VCC), U28.16 (VCC), U53.16 (VCC), U54.16 (VCC), U55.16 (VCC), U56.16 (VCC), U58.11 (VCC), U76.16 (VCC); also elsewhere on the board
+6V: J3.A42 (Pin_a42), J3.B42 (Pin_b42)
+12V: J3.A41 (Pin_a41), J3.B41 (Pin_b41); also elsewhere on the board
-6V: J3.A38 (Pin_a38), J3.B38 (Pin_b38)
/CPU/Z0: U54.12 (DI3), U54.14 (DO3), U58.30 (A0)
/CPU/Z1: U54.9 (DI2), U54.11 (DO2), U58.31 (A1)
/CPU/Z2: U54.5 (DO1), U54.7 (DI1), U58.32 (A2)
/CPU/Z3: U54.2 (DO0), U54.4 (DI0), U58.33 (A3)
/CPU/Z4: U53.5 (DO1), U53.7 (DI1), U58.34 (A4)
/CPU/Z5: U53.2 (DO0), U53.4 (DI0), U58.35 (A5)
/CPU/Z6: U53.12 (DI3), U53.14 (DO3), U58.36 (A6)
/CPU/Z7: U53.9 (DI2), U53.11 (DO2), U58.37 (A7)
/CPU/Z8: U55.9 (DI2), U55.11 (DO2), U58.38 (A8)
/CPU/Z9: U55.12 (DI3), U55.14 (DO3), U58.39 (A9)
/CPU/Z10: U55.2 (DO0), U55.4 (DI0), U58.40 (A10)
/CPU/Z11: U55.5 (DO1), U55.7 (DI1), U58.1 (A11)
/CPU/Z12: U56.2 (DO0), U56.4 (DI0), U58.2 (A12)
/CPU/Z13: U56.12 (DI3), U56.14 (DO3), U58.3 (A13)
/CPU/Z14: U56.5 (DO1), U56.7 (DI1), U58.4 (A14)
/CPU/Z15: U56.9 (DI2), U56.11 (DO2), U58.5 (A15)
A0: J3.B14 (Pin_b14), U54.13 (DB3), Z6.2; also elsewhere on the board
A1: J3.B15 (Pin_b15), U54.10 (DB2), Z6.4; also elsewhere on the board
A2: J3.B16 (Pin_b16), U54.6 (DB1), Z6.6; also elsewhere on the board
A3: J3.B17 (Pin_b17), U54.3 (DB0), Z6.7; also elsewhere on the board
A4: J3.B18 (Pin_b18), U53.6 (DB1), Z6.10; also elsewhere on the board
A5: J3.B19 (Pin_b19), U53.3 (DB0), Z6.12; also elsewhere on the board
A6: J3.B20 (Pin_b20), U53.13 (DB3), Z6.13; also elsewhere on the board
A7: J3.B21 (Pin_b21), U53.10 (DB2), Z6.16; also elsewhere on the board
A8: J3.A14 (Pin_a14), U55.10 (DB2), Z6.1; also elsewhere on the board
A9: J3.A15 (Pin_a15), U55.13 (DB3), Z6.3; also elsewhere on the board
A10: J3.A16 (Pin_a16), U55.3 (DB0), Z6.5; also elsewhere on the board
A11: J3.A17 (Pin_a17), U55.6 (DB1), Z6.8; also elsewhere on the board
A12: J3.A18 (Pin_a18), JP1.4, R40.2, U56.3 (DB0), Z6.9; also elsewhere on the board
A13: J3.A19 (Pin_a19), JP1.3, R39.2, U56.13 (DB3), Z6.11; also elsewhere on the board
A14: J3.A20 (Pin_a20), JP1.2, R36.2, U56.6 (DB1), Z6.14; also elsewhere on the board
A15: J3.A21 (Pin_a21), JP1.1, R37.2, U56.10 (DB2), Z6.15; also elsewhere on the board
BD0: GBR3.2 (R1), J3.B29 (Pin_b29), U15.12 (DI3), U15.13 (DB3), U15.14 (DO3), U58.14 (D0), Z6.30; also elsewhere on the board
BD1: GBR3.4 (R3), J3.B30 (Pin_b30), U15.5 (DO1), U15.6 (DB1), U15.7 (DI1), U58.15 (D1), Z6.31; also elsewhere on the board
BD2: GBR3.8 (R7), J3.B31 (Pin_b31), U14.12 (DI3), U14.13 (DB3), U14.14 (DO3), U58.12 (D2), Z6.27; also elsewhere on the board
BD3: GBR3.7 (R6), J3.B32 (Pin_b32), U14.2 (DO0), U14.3 (DB0), U14.4 (DI0), U58.8 (D3), Z6.28; also elsewhere on the board
BD4: GBR3.3 (R2), J3.A29 (Pin_a29), U15.9 (DI2), U15.10 (DB2), U15.11 (DO2), U58.7 (D4), Z6.29; also elsewhere on the board
BD5: GBR3.5 (R4), J3.A30 (Pin_a30), U15.2 (DO0), U15.3 (DB0), U15.4 (DI0), U58.9 (D5), Z6.32; also elsewhere on the board
BD6: GBR3.9 (R8), J3.A31 (Pin_a31), U14.9 (DI2), U14.10 (DB2), U14.11 (DO2), U58.10 (D6), Z6.26; also elsewhere on the board
BD7: GBR3.6 (R5), J3.A32 (Pin_a32), U14.5 (DO1), U14.6 (DB1), U14.7 (DI1), U58.13 (D7), Z6.25; also elsewhere on the board
BUSAK: U42.9, U53.1 (~CS), U54.1 (~CS), U55.1 (~CS), U57.6, U69.10, U69.13, U76.1 (~CS)
GND: C11.2, C12.2, C13.2, C17.2, J3.A43 (Pin_a43), J3.B43 (Pin_b43), U14.8 (GND), U15.8 (GND), U28.8 (GND), U28.13 (~CE1), U28.14 (~CE2), U53.8 (GND), U53.15 (~DIEN), U54.8 (GND), U54.15 (~DIEN), U55.8 (GND), U55.15 (~DIEN), U56.8 (GND), U56.15 (~DIEN), U58.29 (GND), U69.1, U75.1 (A), U76.8 (GND), U76.15 (~DIEN); also elsewhere on the board
IE: J3.B25 (Pin_b25), Z39B1.1 (Pin_1_1)
unnamed: C11.1, R43.1, U41.5
unnamed: C13.1, R62.2, R63.2, U57.12, U57.13
unnamed: C17.1, R78.2, U41.9, U42.6
unnamed: C12.1, D3.2 (A), R65.2, U57.9
unnamed: T3.1 (Pin_1_1), U58.27 (~M1), U69.9
unnamed: R48.2, U14.1 (~CS), U15.1 (~CS), U28.11 (Q2)
unnamed: R49.2, U14.15 (~DIEN), U15.15 (~DIEN), U28.12 (Q1)
unnamed: U56.1 (~CS), U57.3
unnamed: U57.4, U57.5, U58.23 (~BUSACK)
unnamed: U58.20 (~IORQ), U76.5 (DO1), U76.7 (DI1)
unnamed: U58.19 (~MREQ), U76.2 (DO0), U76.4 (DI0)
unnamed: U58.21 (~RD), U76.9 (DI2), U76.11 (DO2)
unnamed: U58.28 (~RFSH), U69.12
unnamed: U40.9, U58.22 (~WR), U76.12 (DI3), U76.14 (DO3)
unnamed: U44.2, U59.3 (C)
unnamed: R64.2, U59.2 (D), U59.4 (~S)
unnamed: U59.5 (Q), U75.2 (B)
unnamed: U57.11, U59.1 (~R)
unnamed: R21.2, U59.11 (C), U59.12 (D)
unnamed: U59.9 (Q), Z23B1.1 (Pin_1_1)
unnamed: U59.8 (~Q), Z24B1.1 (Pin_1_1)
unnamed: C14.2, U75.14 (Cext)
unnamed: R221.1, U75.3 (Clr)
unnamed: C14.1, R58.1, U75.15 (RCext)
unnamed: U57.10, U75.4 (~Q)
unnamed: U4.4, Z1.1 (Pin_1_1)
unnamed: U4.8, Z2.1 (Pin_1_1)
unnamed: U4.10, Z3.1 (Pin_1_1)
unnamed: U4.12, Z4.1 (Pin_1_1)
unnamed: R83.2, U57.2, Z23A1.1 (Pin_1_1)
unnamed: U4.3, U4.9, U4.11, U4.13, Z24.1 (Pin_1_1)
PHI_VID: R42.2, U58.6 (~CLK), U69.2; also elsewhere on the board
RD: U40.10; also elsewhere on the board
RESIN: R62.1; also elsewhere on the board
RESOUT: U42.5, U44.5, U57.8; also elsewhere on the board
TINT: U42.3; also elsewhere on the board
TNMI: U41.10, Z28A1.1 (Pin_1_1); also elsewhere on the board
WR: R43.2, U40.8, U41.4; also elsewhere on the board
~BUSAK: J3.A13 (Pin_a13), R79.2, U28.4 (A3), U42.8, U57.1, Z34A2.1 (Pin_1_1), Z34B1.1 (Pin_1_1)
~BUSRQ: J3.B13 (Pin_b13), R60.2, U58.25 (~BUSRQ), Z33A1.1 (Pin_1_1), Z33B1.1 (Pin_1_1)
~IE: J3.A25 (Pin_a25)
~INT: J3.B24 (Pin_b24), R61.2, U42.4, U58.16 (~INT), Z38B1.1 (Pin_1_1)
~IORQ: J3.A28 (Pin_a28), U28.6 (A1), U76.6 (DB1), Z6.22; also elsewhere on the board
~IOS: U28.15 (A7); also elsewhere on the board
~M1: J3.A24 (Pin_a24), U28.7 (A2), U44.1, U69.8, Z6.20
~MREQ: J3.A27 (Pin_a27), U76.3 (DB0), Z6.19; also elsewhere on the board
~NMI: J3.B23 (Pin_b23), U41.8, U58.17 (~NMI), Z37B1.1 (Pin_1_1)
~PHI: J3.A22 (Pin_a22), U69.3, Z6.18; also elsewhere on the board
~RAMSEL: U28.2 (A5); also elsewhere on the board
~RAMS: U28.3 (A4); also elsewhere on the board
~RD: J3.A26 (Pin_a26), U28.5 (A0), U40.11, U76.10 (DB2), Z6.23; also elsewhere on the board
~RESOUT: J3.B26 (Pin_b26), T2.1 (Pin_1_1), U44.6, U58.26 (~RESET), U59.13 (~R), Z6.21
~RFSH: J3.B22 (Pin_b22), U69.11, Z6.17; also elsewhere on the board
~ROM: U28.1 (A6); also elsewhere on the board
~WAIT: J3.B28 (Pin_b28), R59.2, U58.24 (~WAIT), Z36A1.1 (Pin_1_1), Z36B1.1 (Pin_1_1)
~WR: J3.B27 (Pin_b27), U59.10 (~S), U76.13 (DB3), Z6.24; also elsewhere on the board

Notes on the sheet:
TOP
EMPTY
BOTTOM
Fix_1

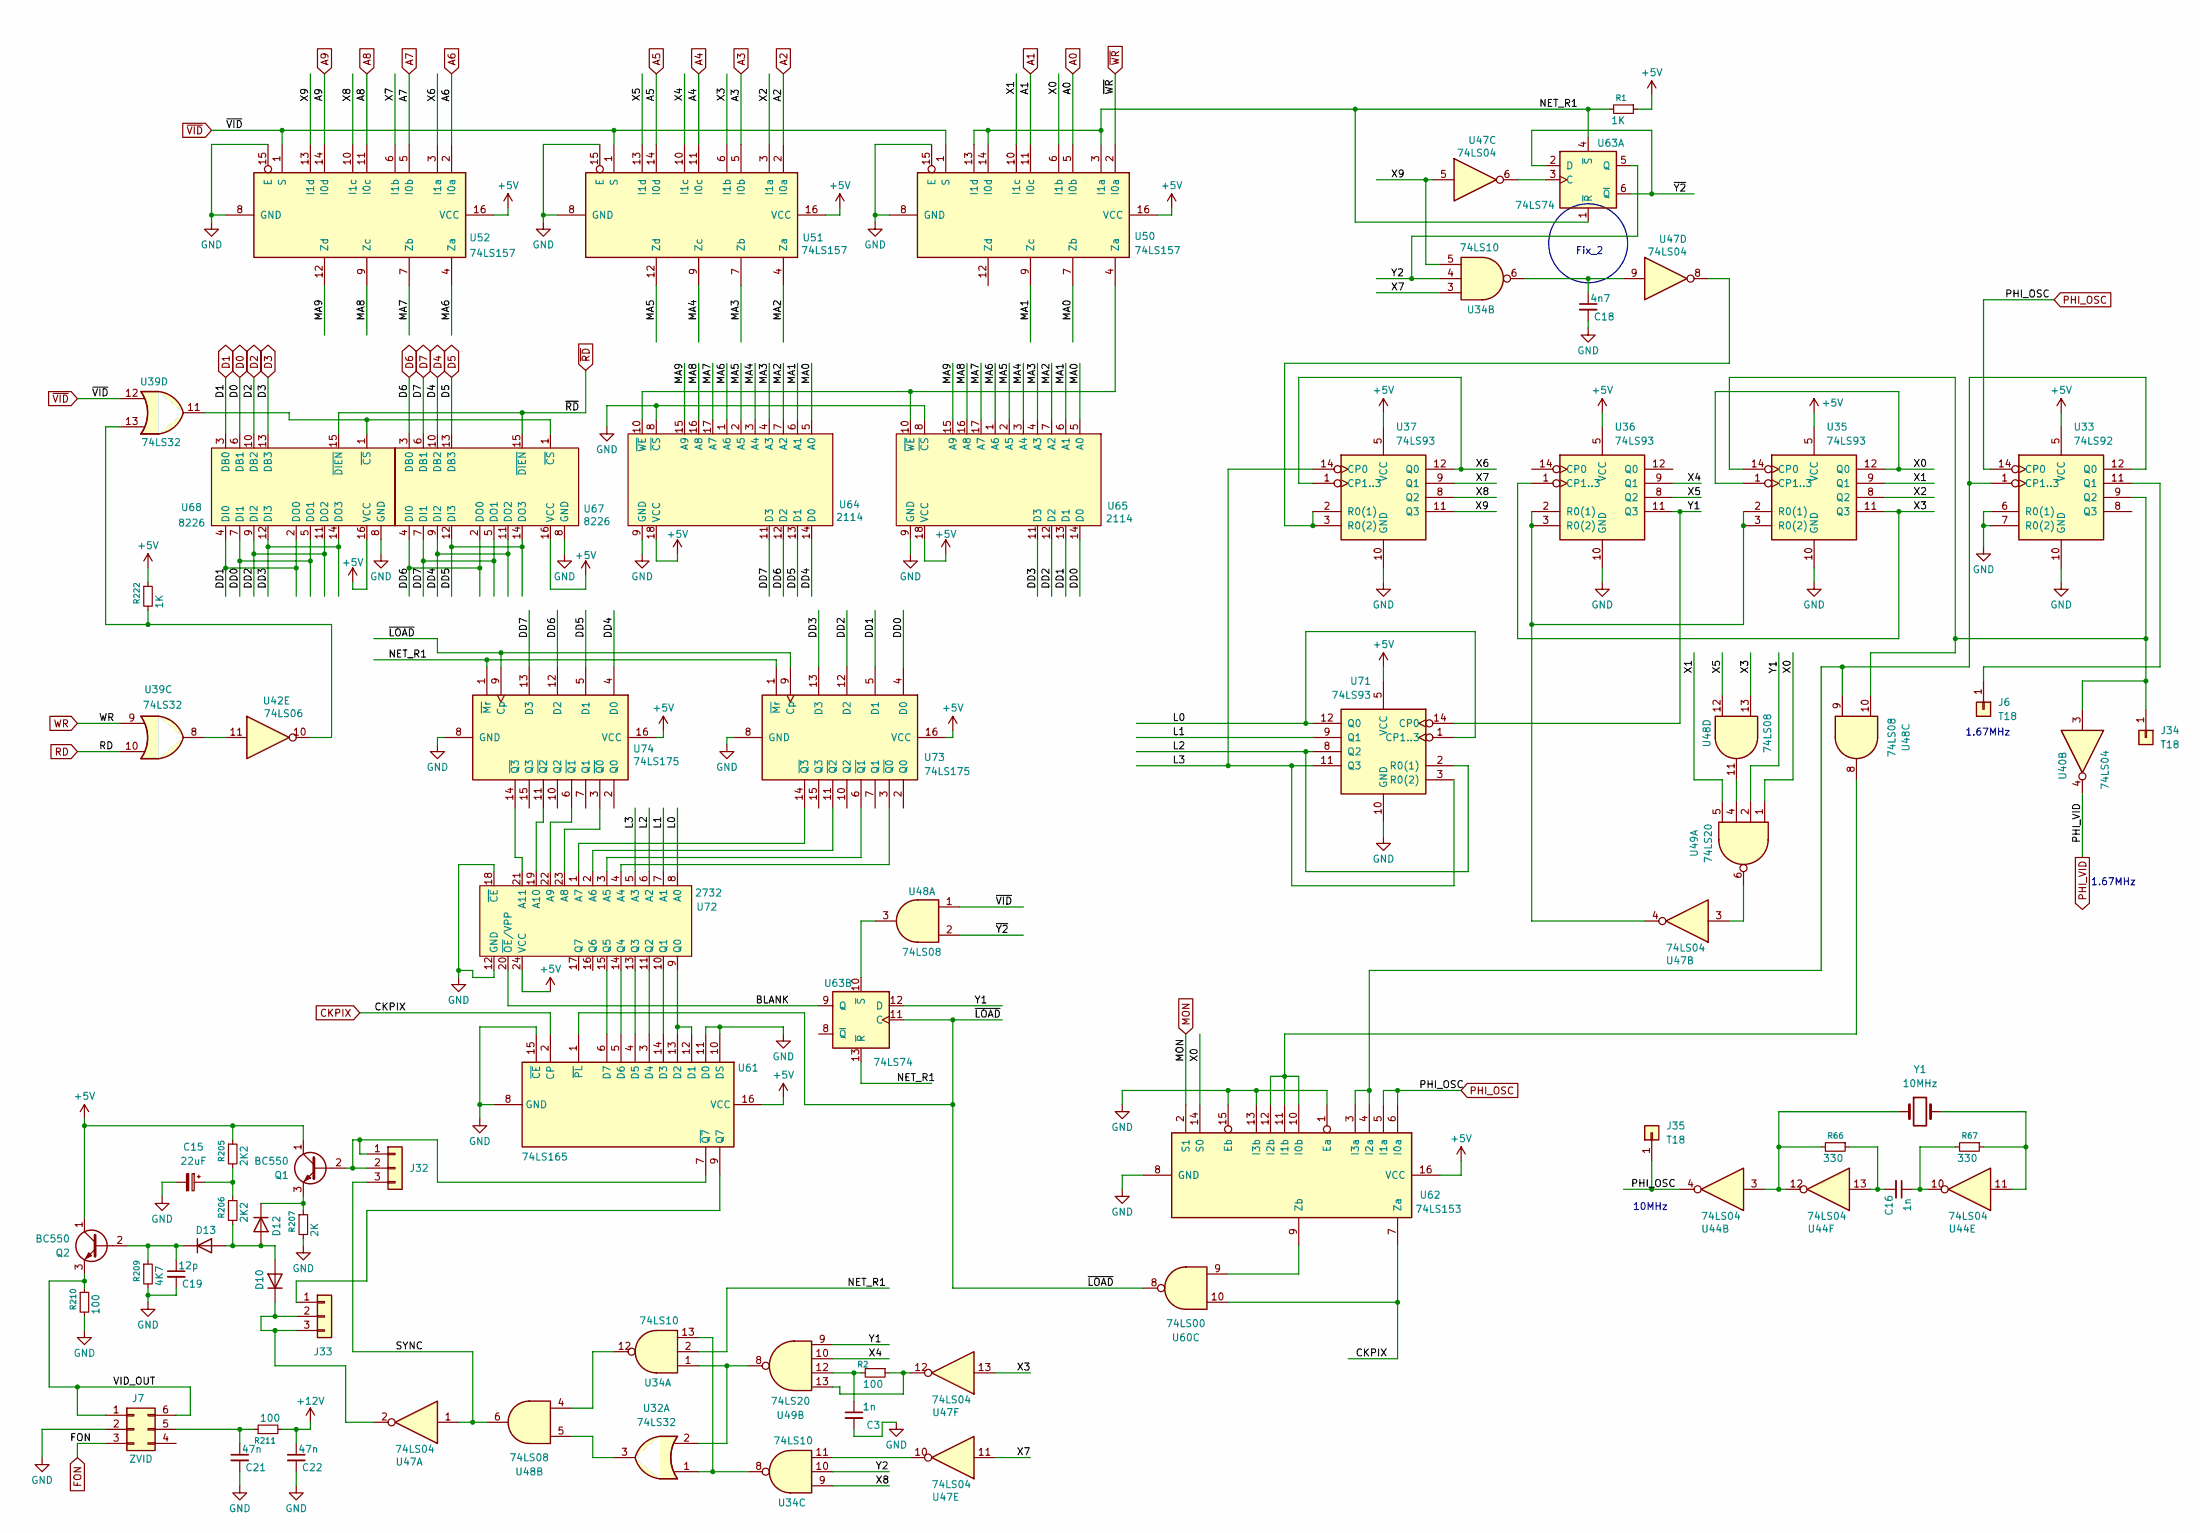
[picture p29: schematic Display.kicad_sch, KOMPUTER MERITUM-1]

Parts:
C3, C16: 1n; c_200
C15: 22uF; CP_Radial_D5.0mm_P2.50mm
C18: 4n7; c_100
C19: 12p; C_Rect_L7.0mm_W2.0mm_P5.00mm
C21, C22: 47n; c_200
D10, D12, D13: 1N4148WT; D_DO-35_SOD27_P10.16mm_Horizontal
J6, J34, J35: T18; pin
J7: ZVID; PinHeader_2x03_P2.54mm_Vertical
J32, J33: Conn_01x03; PinHeader_1x03_P2.54mm_Vertical
Q1, Q2: BC550; TO-92L
R1, R222: 1K; r_400
R2: 100; R_Axial_DIN0207_L6.3mm_D2.5mm_P7.62mm_Horizontal
R66, R67: 330; r_400
R205: 2K2; r_400
R206: 2K2; R_Axial_DIN0207_L6.3mm_D2.5mm_P2.54mm_Vertical
R207: 2K; r_400
R209: 4K7; r_400
R210, R211: 100; r_400
U32, U39: 74LS32; DIP-14_W7.62mm_LongPads
U33: 74LS92; DIP-14_W7.62mm_LongPads
U34: 74LS10; DIP-14_W7.62mm_LongPads
U35, U36, U37, U71: 74LS93; DIP-14_W7.62mm_LongPads
U40, U44, U47: 74LS04; DIP-14_W7.62mm_LongPads
U42: 74LS06; DIP-14_W7.62mm_LongPads
U48: 74LS08; DIP-14_W7.62mm_LongPads
U49: 74LS20; DIP-14_W7.62mm_LongPads
U50, U51, U52: 74LS157; DIP-16_W7.62mm_LongPads
U60: 74LS00; DIP-14_W7.62mm_LongPads
U61: 74LS165; DIP-16_W7.62mm_LongPads
U62: 74LS153; DIP-16_W7.62mm_LongPads
U63: 74LS74; DIP-14_W7.62mm_LongPads
U64, U65: 2114; DIP-18_W7.62mm_Socket_LongPads
U67, U68: 8226; DIP-16_W7.62mm_LongPads
U72: 2732; DIP-24_W15.24mm_LongPads
U73, U74: 74LS175; DIP-16_W7.62mm_LongPads
Y1: 10MHz; Crystal_HC49-4H_Vertical

Connections:
+5V: Q1.1 (C), Q2.1 (C), R1.1, R205.1, R222.1, U33.5 (VCC), U35.5 (VCC), U36.5 (VCC), U37.5 (VCC), U50.16 (VCC), U51.16 (VCC), U52.16 (VCC), U61.16 (VCC), U62.16 (VCC), U64.18 (VCC), U65.18 (VCC), U67.16 (VCC), U68.16 (VCC), U71.5 (VCC), U72.24 (VCC), U73.16 (VCC), U74.16 (VCC); also elsewhere on the board
+12V: C22.1, R211.2; also elsewhere on the board
/Display/BLANK: U63.9 (Q), U72.20 (~OE/VPP)
/Display/DD0: U65.14 (D0), U68.5 (DO1), U68.7 (DI1), U73.4 (D0)
/Display/DD1: U65.13 (D1), U68.2 (DO0), U68.4 (DI0), U73.5 (D1)
/Display/DD2: U65.12 (D2), U68.9 (DI2), U68.11 (DO2), U73.12 (D2)
/Display/DD3: U65.11 (D3), U68.12 (DI3), U68.14 (DO3), U73.13 (D3)
/Display/DD4: U64.14 (D0), U67.9 (DI2), U67.11 (DO2), U74.4 (D0)
/Display/DD5: U64.13 (D1), U67.12 (DI3), U67.14 (DO3), U74.5 (D1)
/Display/DD6: U64.12 (D2), U67.2 (DO0), U67.4 (DI0), U74.12 (D2)
/Display/DD7: U64.11 (D3), U67.5 (DO1), U67.7 (DI1), U74.13 (D3)
/Display/L0: U71.1 (CP1..3), U71.12 (Q0), U72.8 (A0)
/Display/L1: U71.9 (Q1), U72.7 (A1)
/Display/L2: U71.2 (R0(1)), U71.8 (Q2), U72.6 (A2)
/Display/L3: U37.14 (CP0), U71.3 (R0(2)), U71.11 (Q3), U72.5 (A3)
/Display/MA0: U50.7 (Zb), U64.5 (A0), U65.5 (A0)
/Display/MA1: U50.9 (Zc), U64.6 (A1), U65.6 (A1)
/Display/MA2: U51.4 (Za), U64.7 (A2), U65.7 (A2)
/Display/MA3: U51.7 (Zb), U64.4 (A3), U65.4 (A3)
/Display/MA4: U51.9 (Zc), U64.3 (A4), U65.3 (A4)
/Display/MA5: U51.12 (Zd), U64.2 (A5), U65.2 (A5)
/Display/MA6: U52.4 (Za), U64.1 (A6), U65.1 (A6)
/Display/MA7: U52.7 (Zb), U64.17 (A7), U65.17 (A7)
/Display/MA8: U52.9 (Zc), U64.16 (A8), U65.16 (A8)
/Display/MA9: U52.12 (Zd), U64.15 (A9), U65.15 (A9)
/Display/NET_R1: R1.2, U34.2, U50.3 (I1a), U50.13 (I1d), U50.14 (I0d), U63.1 (~R), U63.4 (~S), U63.13 (~R), U73.1 (~Mr), U74.1 (~Mr)
/Display/SYNC: J32.3, U47.1, U48.6
/Display/VID_OUT: J7.1, J7.6, Q2.3 (E), R210.1
/Display/X0: U35.1 (CP1..3), U35.12 (Q0), U49.1, U50.6 (I1b), U62.14 (S0)
/Display/X1: U35.9 (Q1), U49.5, U50.10 (I1c)
/Display/X2: U35.8 (Q2), U51.3 (I1a)
/Display/X3: U35.11 (Q3), U36.1 (CP1..3), U47.13, U48.13, U51.6 (I1b)
/Display/X4: U36.9 (Q1), U49.10, U51.10 (I1c)
/Display/X5: U36.8 (Q2), U48.12, U51.13 (I1d)
/Display/X6: U37.1 (CP1..3), U37.12 (Q0), U52.3 (I1a)
/Display/X7: U34.3, U37.9 (Q1), U47.11, U52.6 (I1b)
/Display/X8: U34.9, U37.8 (Q2), U52.10 (I1c)
/Display/X9: U34.5, U37.11 (Q3), U47.5, U52.13 (I1d)
/Display/Y1: U36.11 (Q3), U49.2, U49.9, U63.12 (D), U71.14 (CP0)
/Display/Y2: U34.4, U34.10, U63.5 (Q)
/Display/~LOAD: U60.8, U61.1 (~PL), U63.11 (C), U73.9 (Cp), U74.9 (Cp)
/Display/~Y2: U48.2, U63.2 (D), U63.6 (~Q)
A0: U50.5 (I0b); also elsewhere on the board
A1: U50.11 (I0c); also elsewhere on the board
A2: U51.2 (I0a); also elsewhere on the board
A3: U51.5 (I0b); also elsewhere on the board
A4: U51.11 (I0c); also elsewhere on the board
A5: U51.14 (I0d); also elsewhere on the board
A6: U52.2 (I0a); also elsewhere on the board
A7: U52.5 (I0b); also elsewhere on the board
A8: U52.11 (I0c); also elsewhere on the board
A9: U52.14 (I0d); also elsewhere on the board
BD0: U68.6 (DB1); also elsewhere on the board
BD1: U68.3 (DB0); also elsewhere on the board
BD2: U68.10 (DB2); also elsewhere on the board
BD3: U68.13 (DB3); also elsewhere on the board
BD4: U67.10 (DB2); also elsewhere on the board
BD5: U67.13 (DB3); also elsewhere on the board
BD6: U67.3 (DB0); also elsewhere on the board
BD7: U67.6 (DB1); also elsewhere on the board
CKPIX: U60.10, U61.2 (CP), U62.7 (Za)
FON: J7.3; also elsewhere on the board
GND: C3.2, C15.2, C18.2, C19.2, C21.2, C22.2, J7.2, R207.2, R209.2, R210.2, U33.6 (R0(1)), U33.7 (R0(2)), U33.10 (GND), U35.10 (GND), U36.10 (GND), U37.10 (GND), U50.8 (GND), U50.15 (E), U51.8 (GND), U51.15 (E), U52.8 (GND), U52.15 (E), U61.8 (GND), U61.10 (DS), U61.11 (D0), U61.15 (~CE), U62.1 (Ea), U62.8 (GND), U62.13 (I3b), U62.15 (Eb), U64.8 (~CS), U64.9 (GND), U65.8 (~CS), U65.9 (GND), U67.8 (GND), U68.8 (GND), U71.10 (GND), U72.12 (GND), U72.18 (~CE), U73.8 (GND), U74.8 (GND); also elsewhere on the board
MON: U62.2 (S1); also elsewhere on the board
unnamed: C3.1, R2.2, U49.12
unnamed: C15.1, R205.2, R206.1
unnamed: C16.1, R67.2, U44.10
unnamed: C16.2, R66.1, U44.13
unnamed: C18.1, U34.6, U47.9
unnamed: D10.2 (A), D12.2 (A), D13.2 (A), R206.2
unnamed: D10.1 (K), J33.2, J33.3, U47.2
unnamed: D12.1 (K), Q1.3 (E), R207.1
unnamed: C19.1, D13.1 (K), Q2.2 (B), R209.1
unnamed: J6.1 (Pin_1_1), U33.11 (Q1)
unnamed: C21.1, J7.5, R211.1
unnamed: J32.1, J32.2, Q1.2 (B), U61.7 (~Q7)
unnamed: J33.1, U61.9 (Q7)
unnamed: J34.1 (Pin_1_1), U33.9 (Q2), U35.14 (CP0), U40.3, U48.10
unnamed: R2.1, U47.12, U49.13
unnamed: R66.2, U44.3, U44.12, Y1.1
unnamed: R67.1, U44.11, Y1.2
unnamed: R222.2, U39.13, U42.10
unnamed: U32.1, U34.8, U34.13
unnamed: U32.2, U34.1, U49.8
unnamed: U32.3, U48.5
unnamed: U33.1 (CP1..3), U33.12 (Q0), U48.9, U62.3 (I3a), U62.4 (I2a)
unnamed: U34.11, U47.10
unnamed: U34.12, U48.4
unnamed: U35.2 (R0(1)), U35.3 (R0(2)), U36.2 (R0(1)), U36.3 (R0(2)), U47.4
unnamed: U37.2 (R0(1)), U37.3 (R0(2)), U47.8
unnamed: U39.8, U42.11
unnamed: U47.3, U49.6
unnamed: U48.11, U49.4
unnamed: U50.4 (Za), U64.10 (~WE), U65.10 (~WE)
unnamed: U61.12 (D1), U61.13 (D2), U72.9 (Q0)
unnamed: U61.14 (D3), U72.10 (Q1)
unnamed: U61.3 (D4), U72.11 (Q2)
unnamed: U61.4 (D5), U72.13 (Q3)
unnamed: U61.5 (D6), U72.14 (Q4)
unnamed: U61.6 (D7), U72.15 (Q5)
unnamed: U48.8, U62.10 (I0b), U62.11 (I1b), U62.12 (I2b)
unnamed: U60.9, U62.9 (Zb)
unnamed: U47.6, U63.3 (C)
unnamed: U48.3, U63.10 (~S)
unnamed: U39.11, U67.1 (~CS), U68.1 (~CS)
unnamed: U72.4 (A4), U73.3 (~Q0)
unnamed: U72.3 (A5), U73.6 (~Q1)
unnamed: U72.2 (A6), U73.11 (~Q2)
unnamed: U72.1 (A7), U73.14 (~Q3)
unnamed: U72.23 (A8), U74.3 (~Q0)
unnamed: U72.22 (A9), U74.6 (~Q1)
unnamed: U72.19 (A10), U74.11 (~Q2)
unnamed: U72.21 (A11), U74.14 (~Q3)
PHI_OSC: J35.1 (Pin_1_1), U33.14 (CP0), U44.4, U62.5 (I1a), U62.6 (I0a); also elsewhere on the board
PHI_VID: U40.4; also elsewhere on the board
RD: U39.10; also elsewhere on the board
WR: U39.9; also elsewhere on the board
~RD: U67.15 (~DIEN), U68.15 (~DIEN); also elsewhere on the board
~VID: U39.12, U48.1, U50.1 (S), U51.1 (S), U52.1 (S); also elsewhere on the board
~WR: U50.2 (I0a); also elsewhere on the board

Notes on the sheet:
1.67MHz
Fix_2
10MHz

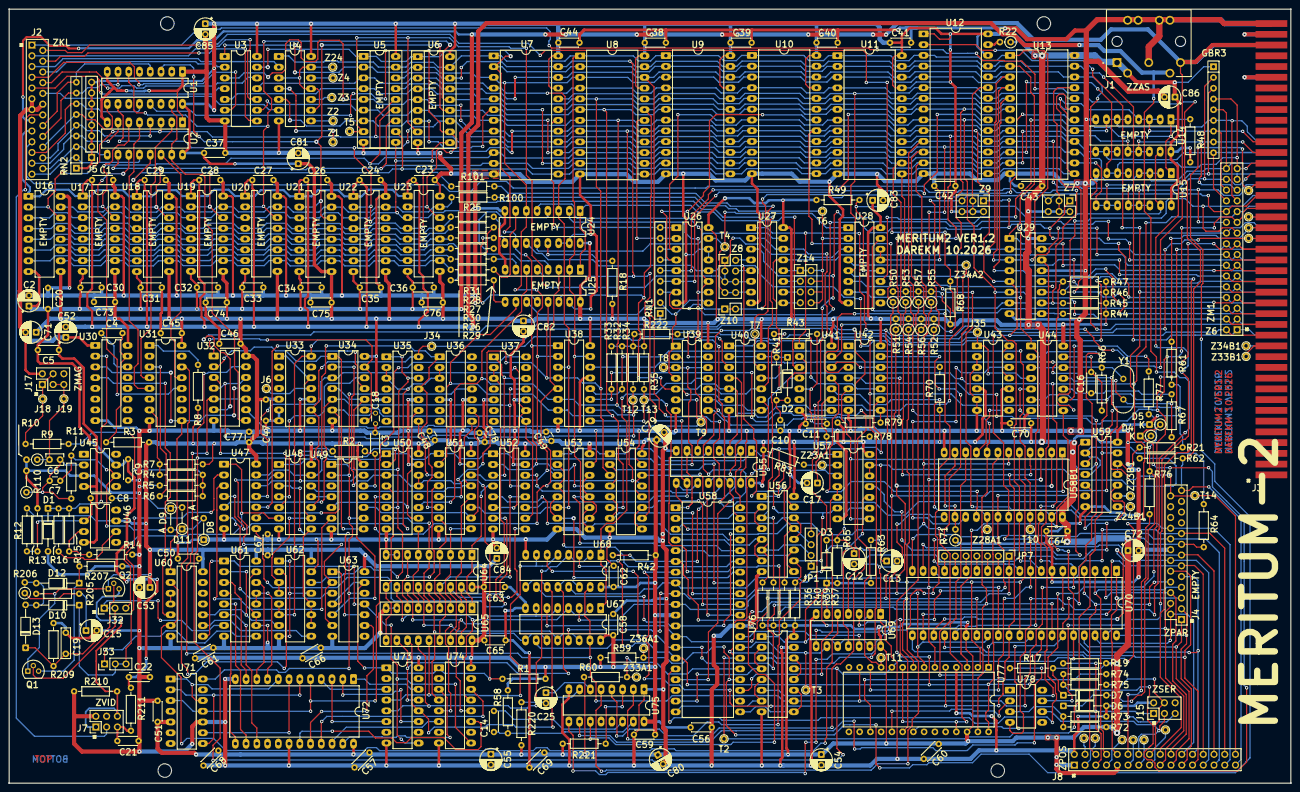
[picture p30: board Meritum_PGW.kicad_pcb from above]

Board: 4 copper layers, 303.0 x 183.0 mm, 331 parts (0 on the bottom side), 330 nets.
